VegaDeftwing/AnalogDrumMachine/README.md

# AnalogDrumMachine
Capstone Project @ UNL, 2020-2021
