VegaDeftwing/AnalogDrumMachine/ProductSpec2.md

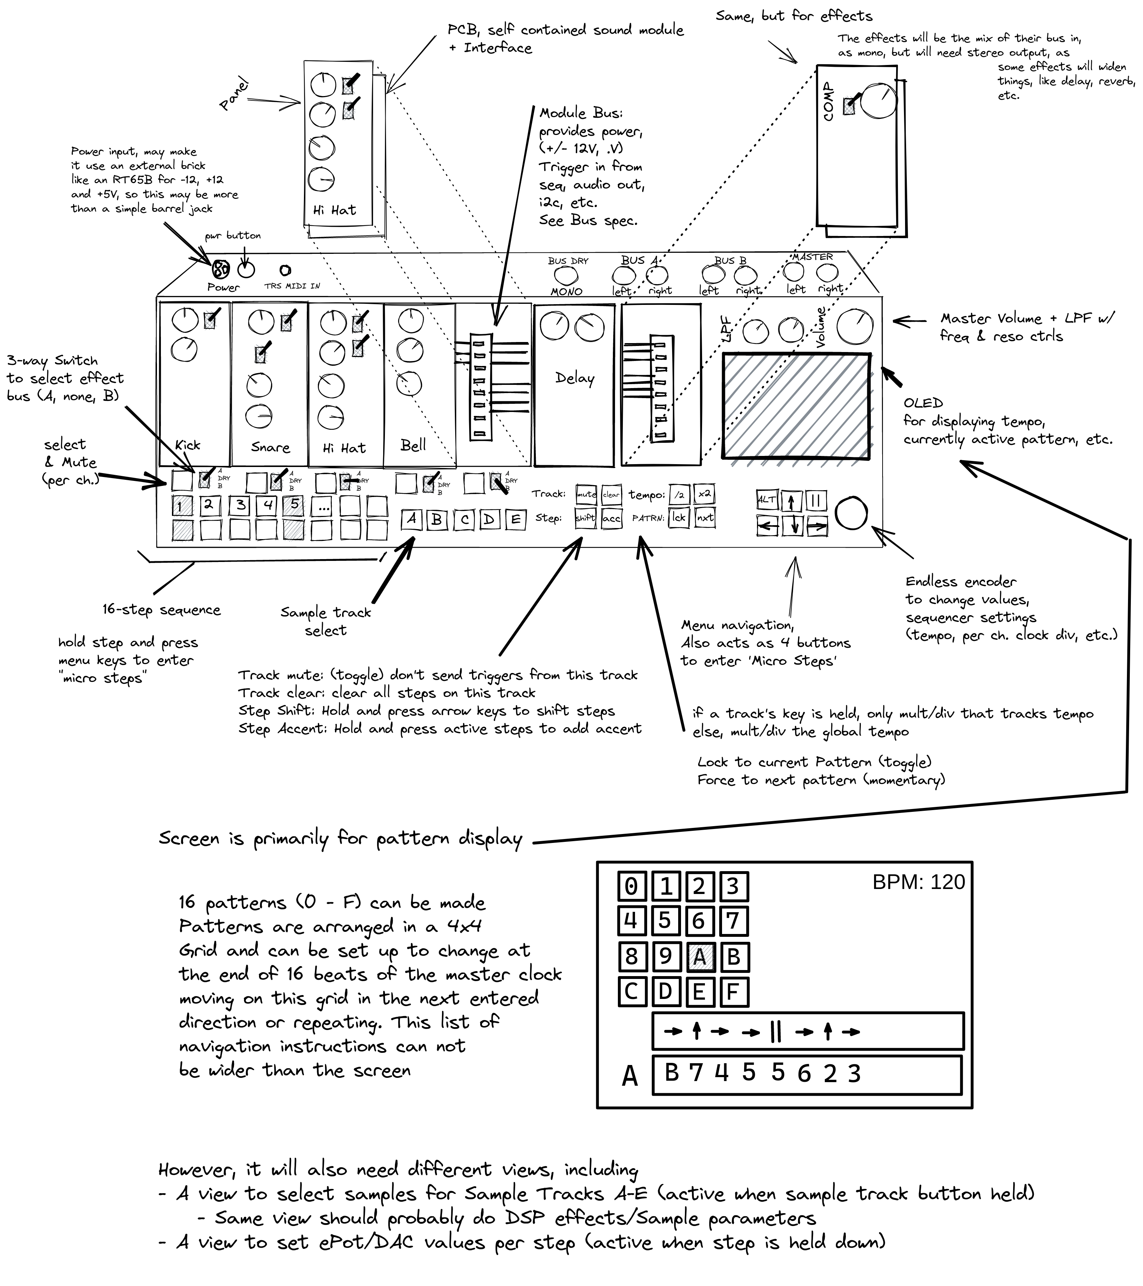
[picture p14: Images/DrumMachineConcept2.png]
DrumMachineConcept2
