VegaDeftwing/AnalogDrumMachine/Poster Board/Power_Enclosure.pdf

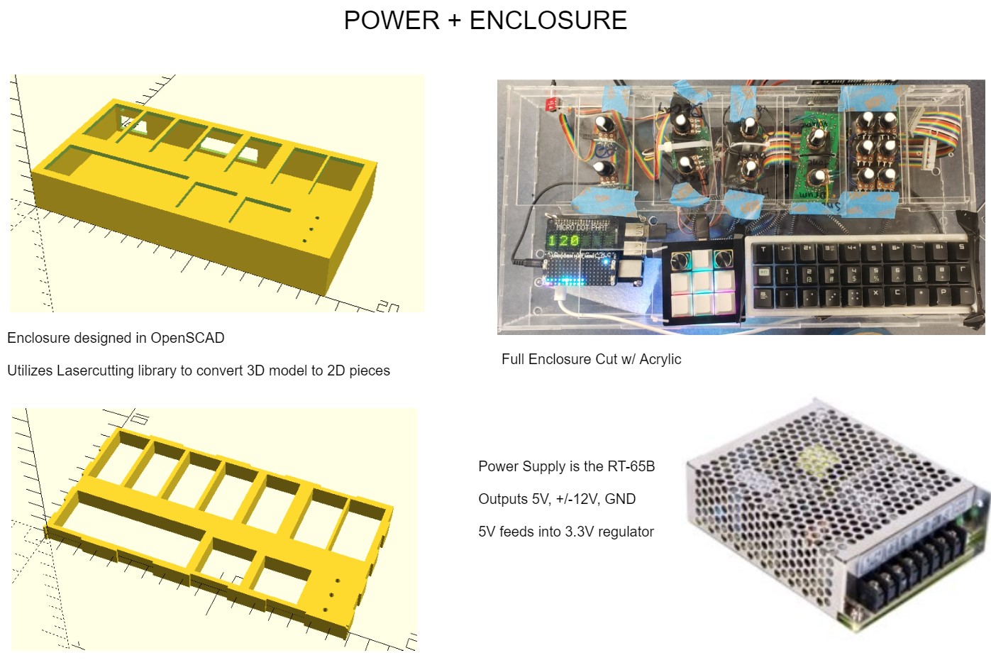
[picture p15: page 1]
