VegaDeftwing/AnalogDrumMachine/Poster Board/Snare.pdf

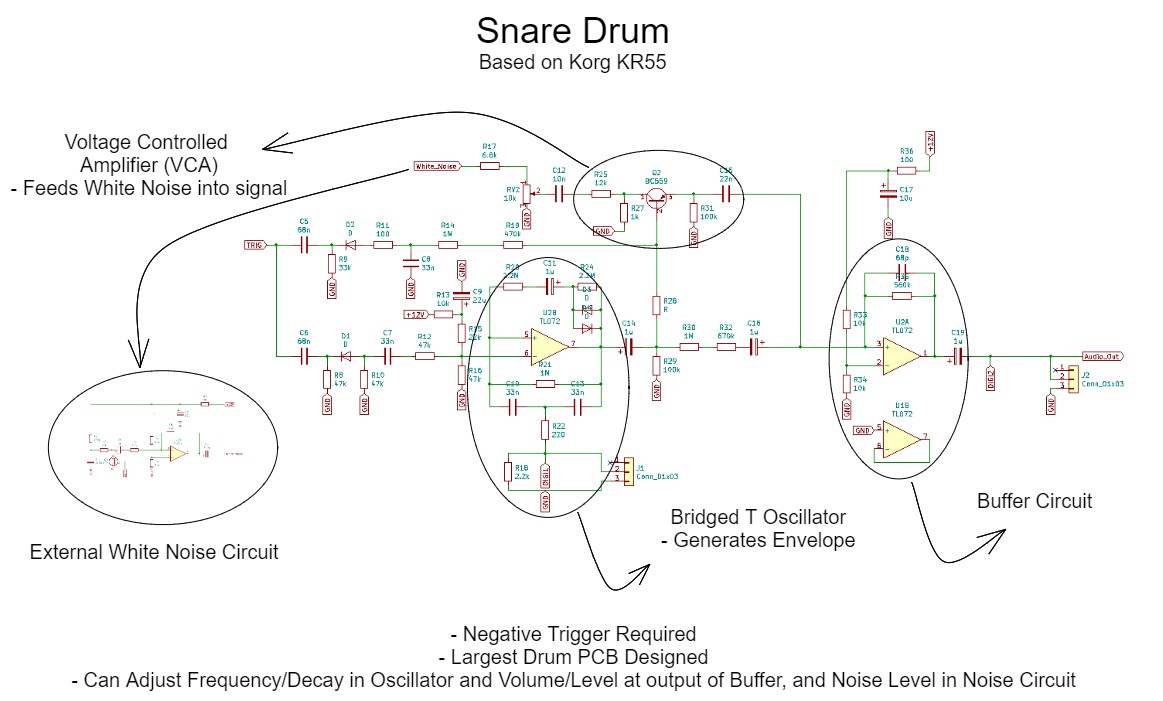
[picture p16: page 1]
