VegaDeftwing/AnalogDrumMachine/Poster Board/Title.pdf

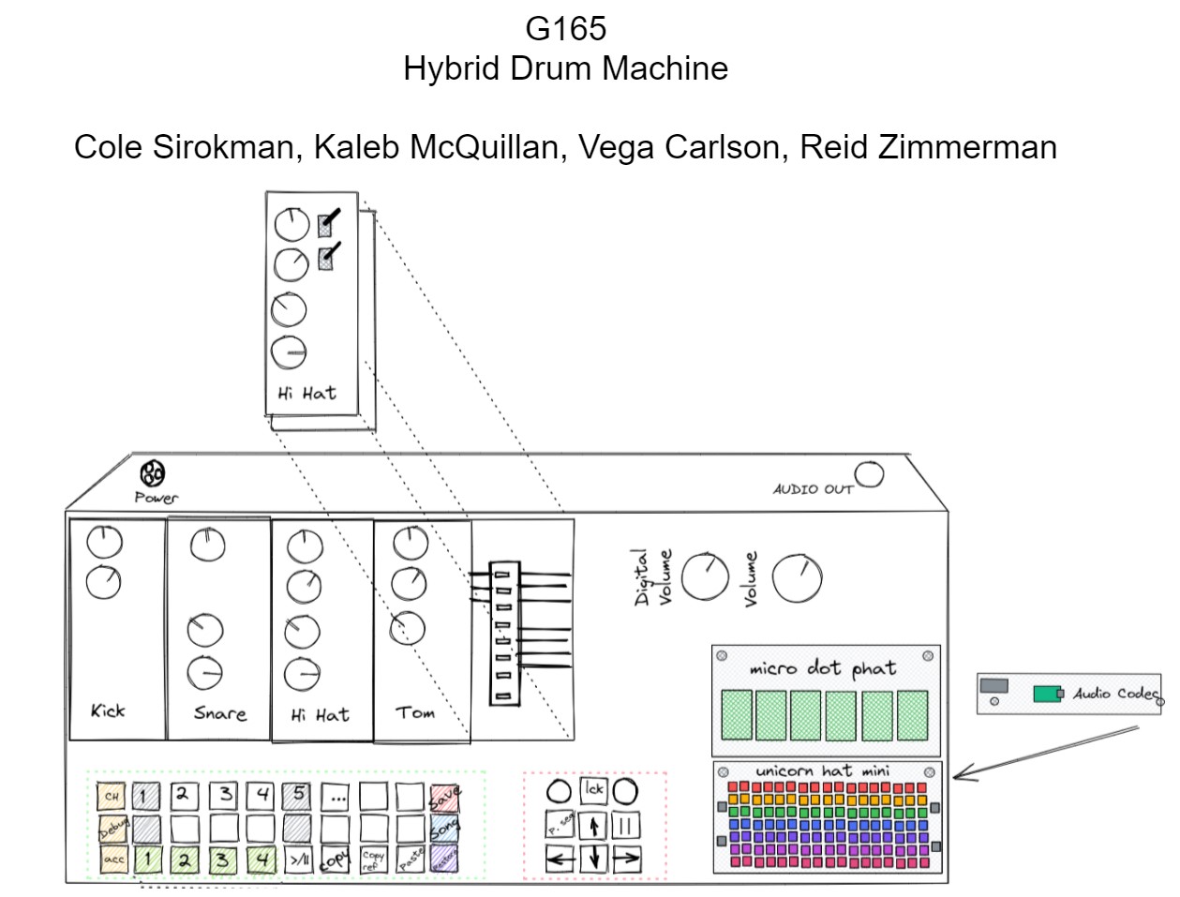
[picture p17: page 1]
