VegaDeftwing/AnalogDrumMachine/Images/displays.jpg

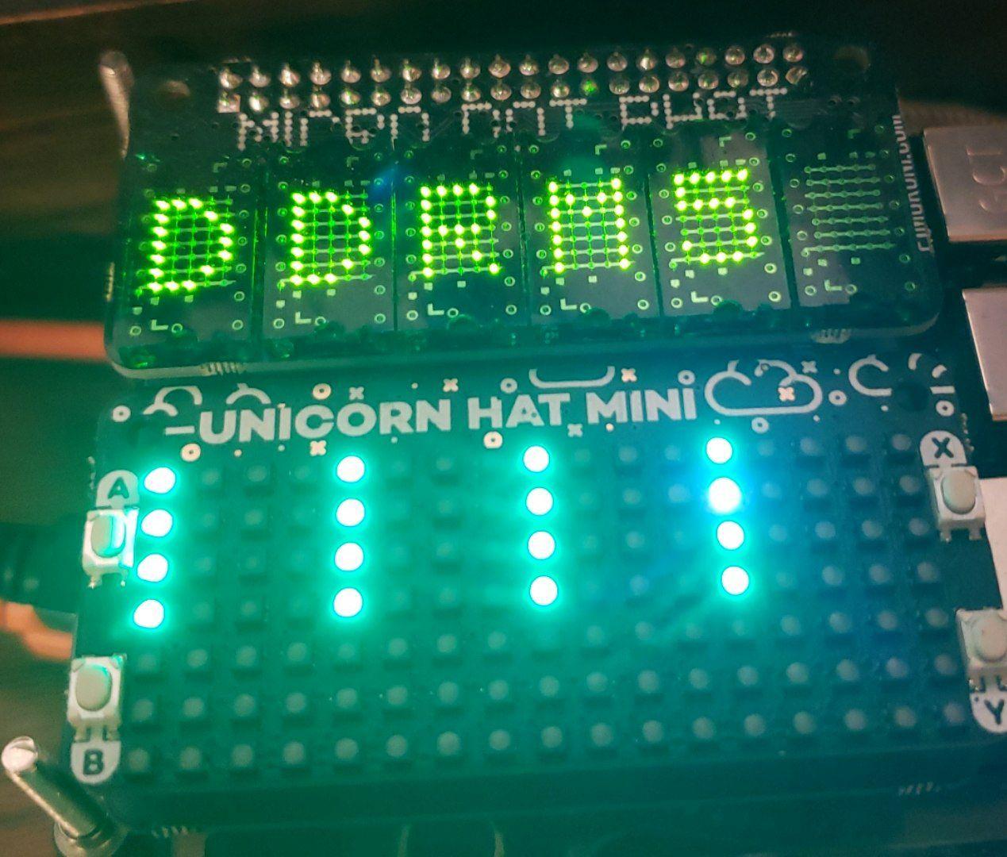
Images/displays.jpg
