VegaDeftwing/AnalogDrumMachine/Images/DrumMachineConcept5pretty.png

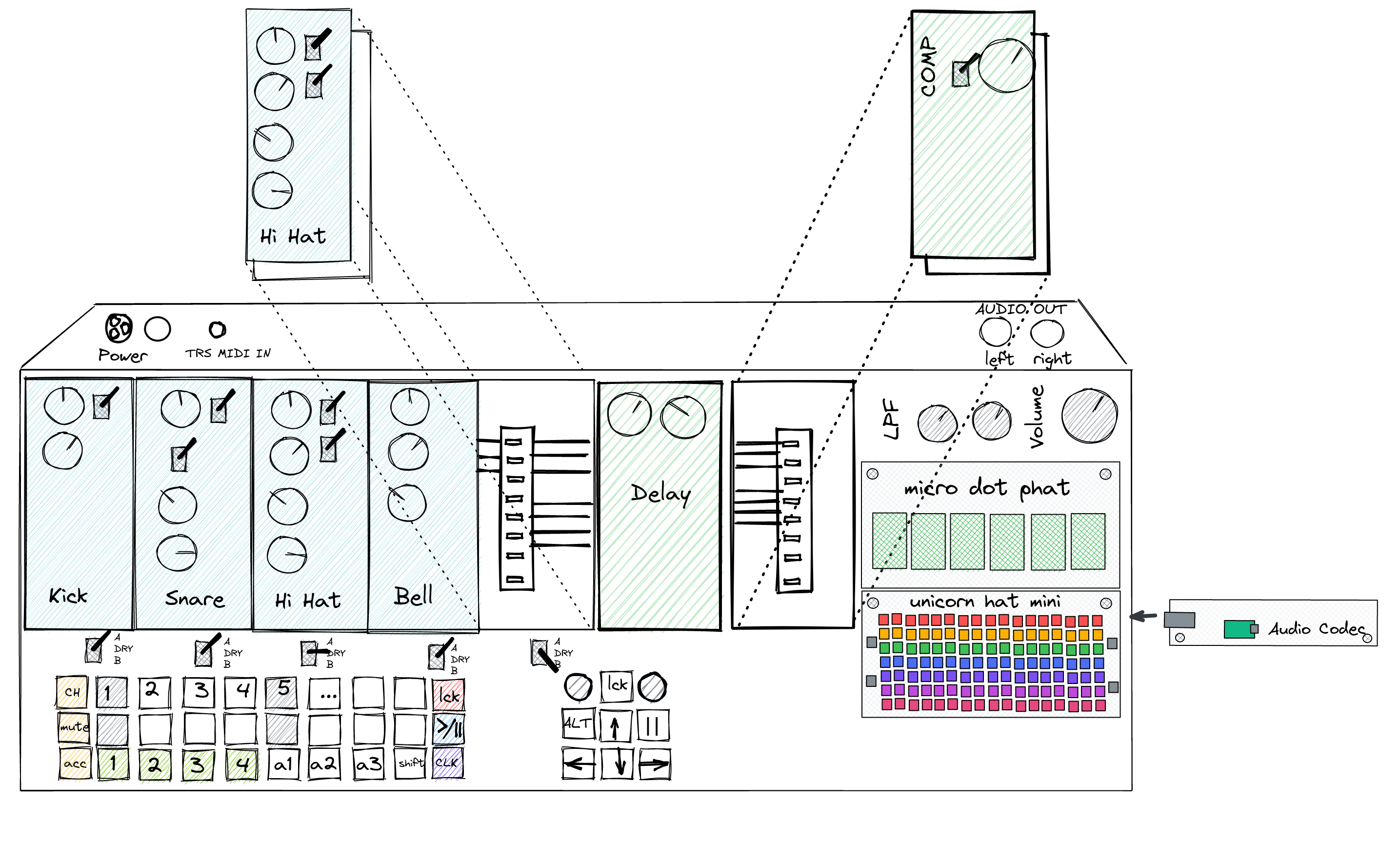
Images/DrumMachineConcept5pretty.png
