VegaDeftwing/AnalogDrumMachine/Images/Enclosure_Top.PNG

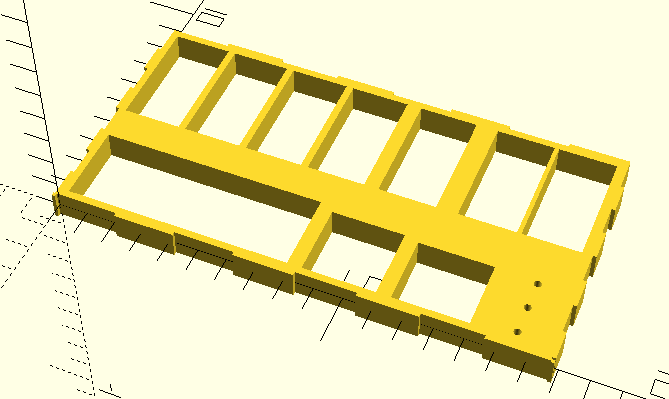
Images/Enclosure_Top.PNG
