VegaDeftwing/AnalogDrumMachine/Images/noise.PNG

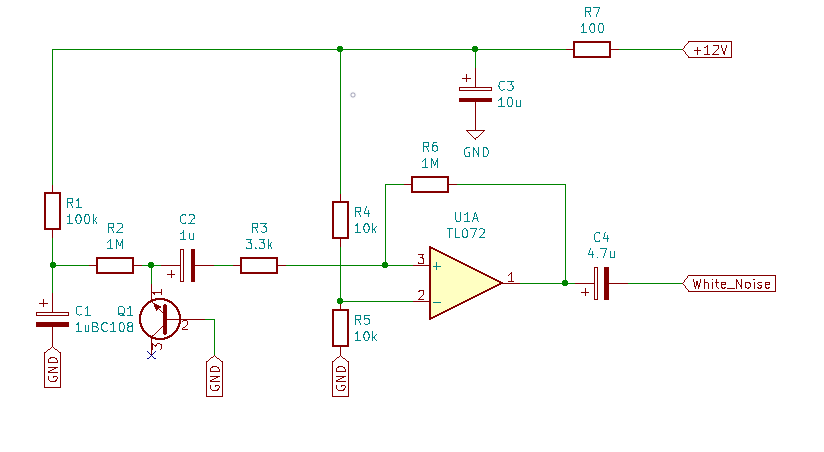
Images/noise.PNG
