VegaDeftwing/AnalogDrumMachine/Images/snare.PNG

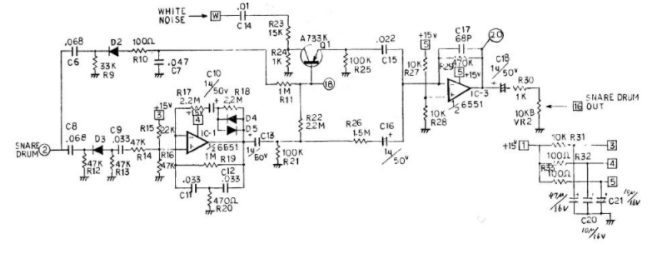
Images/snare.PNG
