VegaDeftwing/AnalogDrumMachine/Images/snare_kicad.PNG

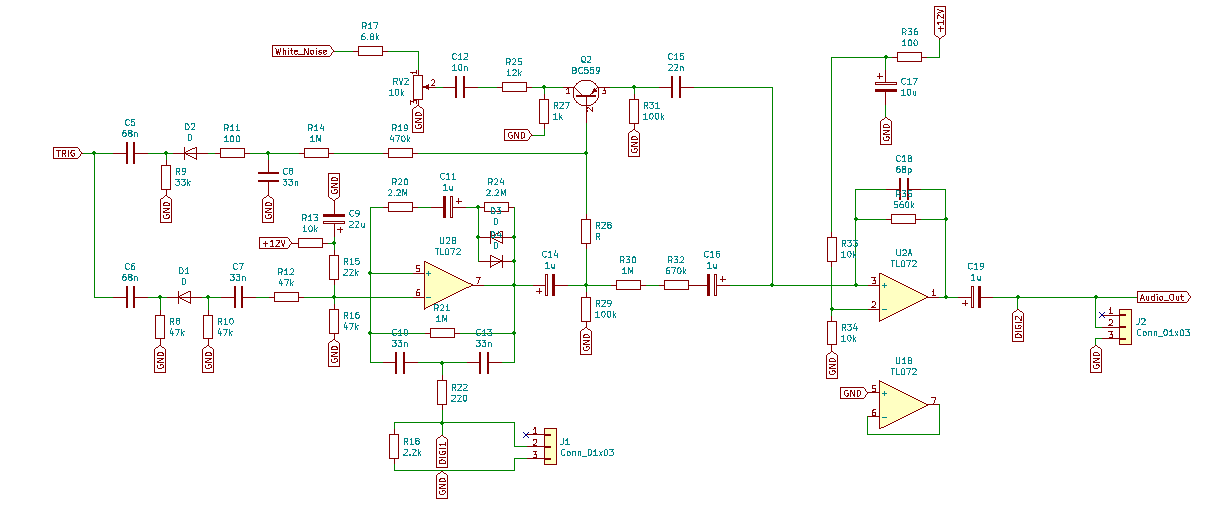
Images/snare_kicad.PNG
