VegaDeftwing/AnalogDrumMachine/Images/Supply.PNG

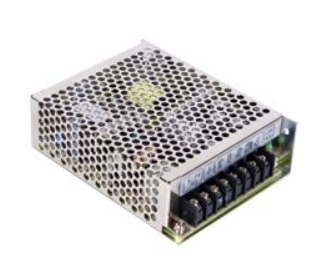
Images/Supply.PNG
