VegaDeftwing/AnalogDrumMachine/PCBs/Delay PCB/delaySchematic.png

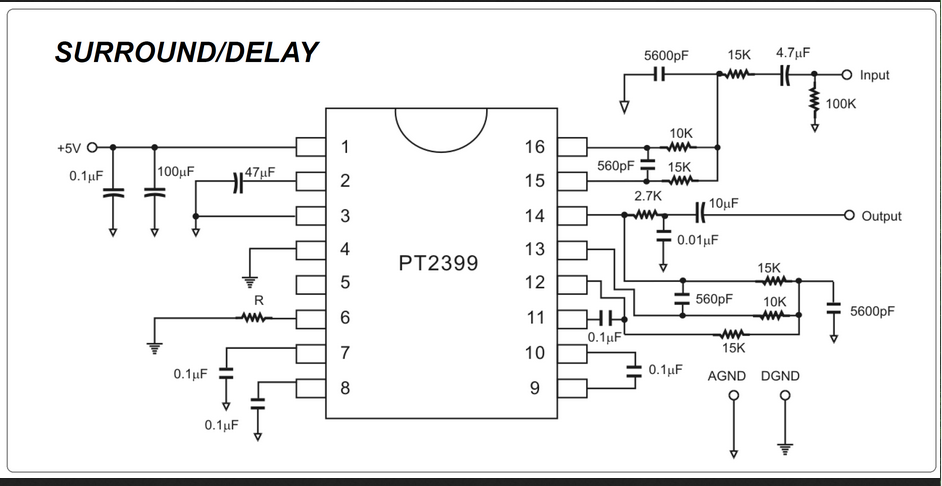
PCBs/Delay PCB/delaySchematic.png
