VegaDeftwing/AnalogDrumMachine/BOM/ControlBoardBOM.xlsx

Component | Value | Footprint | Description | Type | Description | Availability
C1 | 15pF | Capacitor_SMD:C_0805_2012Metric | Device | C | Unpolarized capacitor | Y
C2 | 15pF | Capacitor_SMD:C_0805_2012Metric | Device | C | Unpolarized capacitor | Y
C3 | 100nF | Capacitor_SMD:C_0805_2012Metric | Device | C | Unpolarized capacitor | Y
C4 | 10uF | Capacitor_SMD:C_0805_2012Metric | Device | C | Unpolarized capacitor | N
C5 | 100nF | Capacitor_SMD:C_0805_2012Metric | Device | C | Unpolarized capacitor | Y
C6 | 10uF | Capacitor_SMD:C_0805_2012Metric | Device | C | Unpolarized capacitor | N
C7 | 100nF | Capacitor_SMD:C_0805_2012Metric | Device | C | Unpolarized capacitor | Y
C8 | 100nF | Capacitor_SMD:C_0805_2012Metric | Device | C | Unpolarized capacitor | Y
C9 | 100nF | Capacitor_SMD:C_0805_2012Metric | Device | C | Unpolarized capacitor | Y
C10 | 100nF | Capacitor_SMD:C_0805_2012Metric | Device | C | Unpolarized capacitor | Y
C11 | 10uF | Capacitor_SMD:C_0805_2012Metric | Device | C | Unpolarized capacitor | N
D1 | D_Schottky | Diode_SMD:D_1206_3216Metric | Device | D_Schottky | Schottky diode | ?
D2 | LED | LED_SMD:LED_0805_2012Metric | Device | LED | Light emitting diode | ?
D3 | LED | LED_SMD:LED_0805_2012Metric | Device | LED | Light emitting diode | ?
D4 | LED | LED_SMD:LED_0805_2012Metric | Device | LED | Light emitting diode | ?
D5 | LED | LED_SMD:LED_0805_2012Metric | Device | LED | Light emitting diode | ?
J1 | USB_B_Micro | Connector_USB:USB_Micro-B_Molex_47346-0001 | rev1-rescue | USB_B_Micro-Connector |  | ?
J2 | Conn_01x03 | Connector_PinHeader_2.54mm:PinHeader_1x03_P2.54mm_Vertical | Connector_Generic | Conn_01x03 | Generic connector, single row, 01x03, script generated (kicad-library-utils/schlib/autogen/connector/) | Female or male?
J3 | Conn_01x08 | Connector_PinHeader_2.54mm:PinHeader_1x08_P2.54mm_Vertical | Connector_Generic | Conn_01x08 | Generic connector, single row, 01x08, script generated (kicad-library-utils/schlib/autogen/connector/) | Female or male?
J4 | Conn_01x05 | Connector_PinHeader_1.27mm:PinHeader_1x05_P1.27mm_Vertical | Connector_Generic | Conn_01x05 | Generic connector, single row, 01x05, script generated (kicad-library-utils/schlib/autogen/connector/) | Female or male?
J5 | Conn_01x04 | Connector_PinHeader_1.27mm:PinHeader_1x04_P1.27mm_Vertical | Connector_Generic | Conn_01x04 | Generic connector, single row, 01x04, script generated (kicad-library-utils/schlib/autogen/connector/) | Female or male?
J6 | Conn_01x01 | Connector_PinHeader_2.54mm:PinHeader_1x01_P2.54mm_Vertical | Connector_Generic | Conn_01x01 | Generic connector, single row, 01x01, script generated (kicad-library-utils/schlib/autogen/connector/) | Female or male?
R1 | 1K | Resistor_SMD:R_0805_2012Metric | Device | R | Resistor | Y
R2 | 27 | Resistor_SMD:R_0805_2012Metric | Device | R | Resistor | N | have 22 ohm 0805
R3 | 27 | Resistor_SMD:R_0805_2012Metric | Device | R | Resistor | N | have 22 ohm 0805
R4 | 5.6K | Resistor_SMD:R_0805_2012Metric | Device | R | Resistor | Y
R5 | 10K | Resistor_SMD:R_0805_2012Metric | Device | R | Resistor | Y
R6 | 10K | Resistor_SMD:R_0805_2012Metric | Device | R | Resistor | Y
R7 | 1K | Resistor_SMD:R_0805_2012Metric | Device | R | Resistor | Y
R8 | 1K | Resistor_SMD:R_0805_2012Metric | Device | R | Resistor | Y
R9 | 1K | Resistor_SMD:R_0805_2012Metric | Device | R | Resistor | Y
R10 | 1K | Resistor_SMD:R_0805_2012Metric | Device | R | Resistor | Y
R11 | 1K | Resistor_SMD:R_0805_2012Metric | Device | R | Resistor | Y
R12 | 100 | Resistor_SMD:R_0805_2012Metric | Device | R | Resistor | Y
R13 | 10K | Resistor_SMD:R_0805_2012Metric | Device | R | Resistor | Y
R14 | 4.7K | Resistor_SMD:R_0805_2012Metric | Device | R | Resistor | Y
R15 | 4.7K | Resistor_SMD:R_0805_2012Metric | Device | R | Resistor | Y
SW1 | SW_Push | Button_Switch_SMD:SW_SPST_CK_RS282G05A3 | Switch | SW_Push | Push button switch, generic, two pins | ?
U1 | RP2040 | RP2040:RP2040 | rev1-rescue | RP2040-rp2040 |  | ?
U2 | AZ1117-3.3 | Package_TO_SOT_SMD:SOT-223-3_TabPin2 | Regulator_Linear | AZ1117-3.3 | 1A 20V Fixed LDO Linear Regulator, 3.3V, SOT-89/SOT-223/TO-220/TO-252/TO-263 | ?
U3 | W25Q32JVSS | Package_SO:SOIC-8_5.23x5.23mm_P1.27mm | Memory_Flash | W25Q32JVSS | 32Mb Serial Flash Memory, Standard/Dual/Quad SPI, SOIC-8 | ?
Y1 | 12Mhz | Crystal:Crystal_SMD_SeikoEpson_FA238-4Pin_3.2x2.5mm | Device | Crystal_GND24 | Four pin crystal, GND on pins 2 and 4 | ?
