VegaDeftwing/AnalogDrumMachine/CAD/DXF/drumbox_flat_side2.dxf

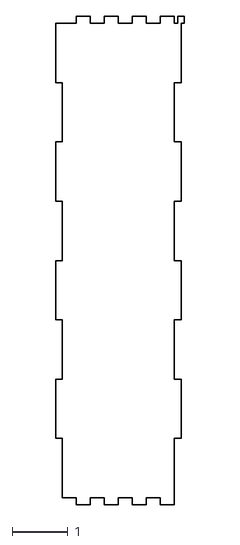
[picture p26: CAD file, 2022-05-05]
CAD/DXF/drumbox_flat_side2.dxf
2.31 x 8.75
