VegaDeftwing/AnalogDrumMachine/CAD/DXF/drumbox_flat.dxf

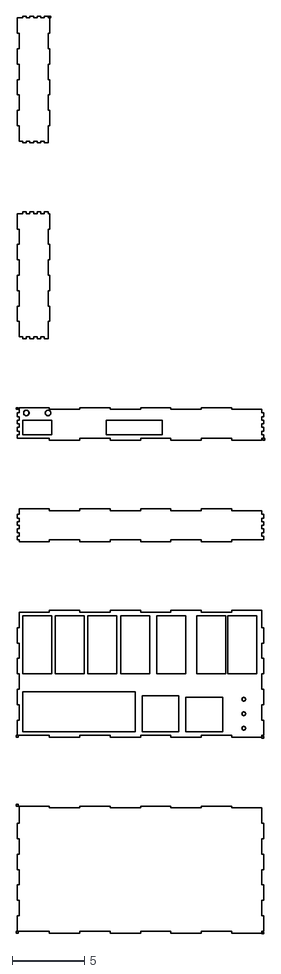
[picture p27: CAD file, 2022-05-05]
CAD/DXF/drumbox_flat.dxf
17.1 x 63.3
