VegaDeftwing/AnalogDrumMachine/CAD/DXF/drumbox_flat_back.dxf

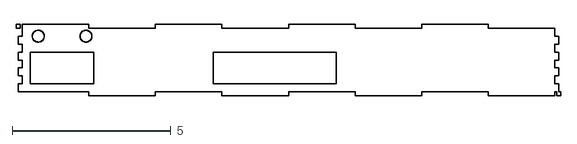
[picture p28: CAD file, 2022-05-05]
CAD/DXF/drumbox_flat_back.dxf
17.1 x 2.25
