VegaDeftwing/AnalogDrumMachine/CAD/DXF/drumbox_flat_top.dxf

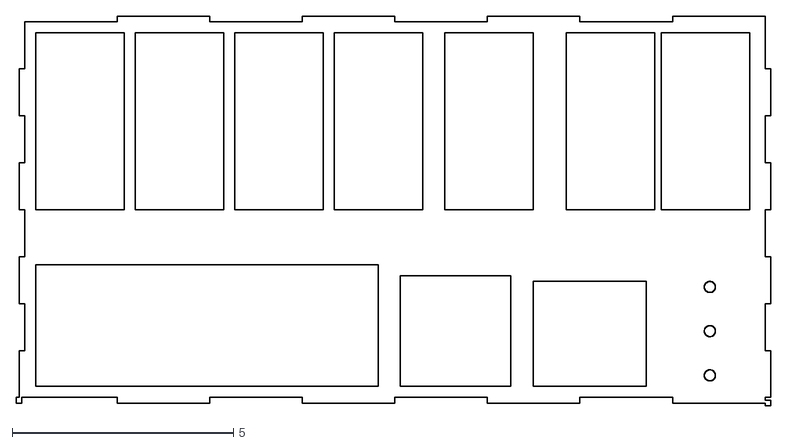
[picture p29: CAD file, 2022-05-05]
CAD/DXF/drumbox_flat_top.dxf
17.1 x 8.81
