VegaDeftwing/AnalogDrumMachine/CAD/DXF/drumbox_flat_side1.dxf

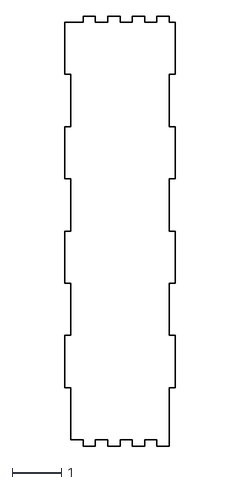
[picture p30: CAD file, 2022-05-05]
CAD/DXF/drumbox_flat_side1.dxf
2.25 x 8.75
