VegaDeftwing/AnalogDrumMachine/CAD/DXF/drumbox_flat_front.dxf

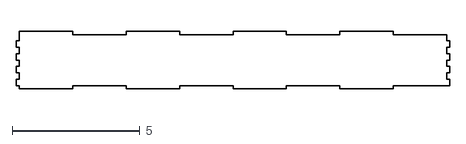
[picture p31: CAD file, 2022-05-05]
CAD/DXF/drumbox_flat_front.dxf
17.0 x 2.25
