VegaDeftwing/AnalogDrumMachine/CAD/DXF/drumbox_flat_bottom.dxf

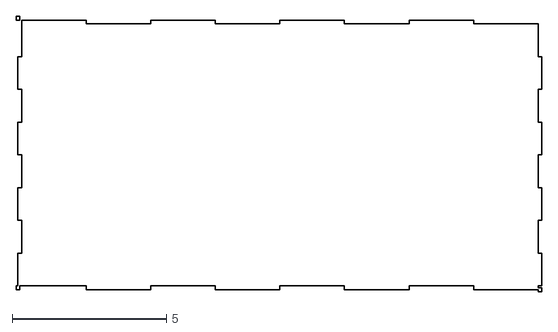
[picture p32: CAD file, 2022-05-05]
CAD/DXF/drumbox_flat_bottom.dxf
17.1 x 8.94
