VegaDeftwing/AnalogDrumMachine/(list of files, cad)

Other CAD files:
CAD/drumbox.scad
CAD/drumbox_flat_bottom.scad
CAD/drumbox_flat_front.scad
CAD/drumbox_flat_side2.scad
drumbox_flat_front.dxf
