VegaDeftwing/AnalogDrumMachine/Journal/VegaCarlsonJournalFall21w15.md

[TOC]

# Vega Carlson - Group 165 - Fall '21, Week 1

## Monday, Aug 2nd W:1.50 T:1.50 

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

## Tuesday, Aug 3rd -- W:5.00 T:5.00

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

exclidraw

This was also uploaded to github: [https://github.com/VegaDeftwing/AnalogDrumMachine](https://github.com/VegaDeftwing/AnalogDrumMachine)

## Wednesday, Aug 4th -- W:7.25 T:7.25

**1hr** Refinements of the concept sketch and feature list

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

harmonics

## Thursday, Aug 5th -- W:8.00 T.8.00

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

daughterboard

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

## Friday, Aug 6th -- W:9.50 T:9.50

**1.5hr** Group meeting, making timeline

---

**Week ending 8/27 total = 9.5hrs**

# Vega Carlson - Group 165 - Fall '21, Week 3

## Saturday, Sep 4th -- W:0.00 T:17.50

**0.00 hr** -- Sick, no progress today

## Sunday, Sep 5th -- W:0.00 T:17.50

**0.00hr** -- Sick, no progress today

## Monday, Sep 6th -- W:1.50 T:19.00

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

## Tuesday, Sep 7th -- W:1.50 T:19.00

**0.00hr** -- Sick, no progress today

## Wednesday, Sep 8th -- W:3.00 T:20.50

**0.5hr** -- Group meeting with Bauer, discussed state of the project, talked about the indistructable laptops

**0.5hr** -- Worked with LiveSpice to get circuit simulation with live audio output working

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

## Thursday, Sep 9th -- W:4.00 T:21.00

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

## Friday, Sep 10th -- W:6.00 T:23.00

**.75hr** Meeting with group

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

---

**Week ending 8/27 total = 6.0hrs**

# Vega Carlson - Group 165 - Fall '21, Week 4

## Saturday, Sep 11th -- W:0.00 T:23.00

**0.00 hr** -- No Progress today

## Sunday, Sep 12th -- W:0.70 T:23.70

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

## Monday, Sep 13th -- W:1.00 T:24.00

**0.3hr** -- Worked with ried building circuits in the lab

## Tuesday, Sep 14th -- W:2.30 T:25.30

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

## Wednesday, Sep 15th -- W:2.80 T:25.8

**0.5hr** - Meeting w/ Bauer

## Thursday, Sep 16th -- W:5.00 T:28.00

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

**1.0hr** - Bus selection, looking at i2c part options

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

## Friday, Sep 17th -- W:8.00 T:31.00

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

**1.2hr** - Group meeting, see minutes

**1.1hr** - Redesign of concept sketch

DrumMachineConcept2

---

**Week ending 9/17 total = **8.0 hours

# Vega Carlson - Group 165 - Fall '21, Week 5

## Saturday, Sep 18th -- W:0.00 T:31.00

**0.00 hr** -- No Progress today

## Sunday, Sep 19th -- W:4.00 T:35.00

**4.00hrs** -- Drastically updated the product spec + discussion with group about some terminology

DrumMachineConcept3

## Monday, Sep 20th -- W:6.00 T:37.0

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

## Tuesday, Sep 21st -- W:6.00 T:37.0

**0.0hr** -- No work on the project today

## Wednesday, Sep 22nd -- W:6.7 T:37.7

**0.5hr** - Meeting w/ Bauer

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

## Thursday, Sep 23rd -- W:6.7 T:37.7

**0.0hr** - No work on the project today

## Friday, Sep 24th -- W:8.00 T:39.0

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

---

**Week ending 9/24 total = **8.0 hours

# Vega Carlson - Group 165 - Fall '21, Week 6

## Saturday, Sep 25th -- W:0.00 T:39.00

**0.00 hr** -- No Progress today

## Sunday, Sep 26th -- W:0.00 T:39.00

**0.00hrs** -- No Progress today

## Monday, Sep 27th -- W:0.50 T:39.5

**0.5hr** -- Worked with Ried in the lab briefly to progress on the sna 

## Tuesday, Sep 28th -- W:5.50 T:44.5

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

## Wednesday, Sep 29th -- W:6.2 T:45.2

**0.0hr** - Meeting w/ Bauer, was significantly late

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

## Thursday, Sep 30th -- W:7.2 T:46.2

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

## Friday, Oct 1st -- W:8.00 T:47.0

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

---

**Week ending 10/1 total = **8.0 hours

# Vega Carlson - Group 165 - Fall '21, Week 7

## Saturday, Oct 2nd -- W:0.00 T:47.00

**0.0 hr** -- No Progress today

## Sunday, Oct 3rd -- W:0.00 T:47.00

**0.0hrs** -- No Progress today

## Monday, Oct 4th -- W:0.60 T:47.6

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

## Tuesday, Oct 5th -- W:0.60 T:47.6

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

## Wednesday, Oct 6th -- W:2.60 T:49.6

**0.5hr** -- Meeting with Bauer

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

## Thursday, Oct 7th -- W:6.1 T:53.1

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

DrumMachineConcept4

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

---

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

## Friday, Oct 8th-- W:8.00 T:55.0

**0.5hr** -- Group meeting in lab

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

---

**Week ending 10/8 total = **8.0 hours

# Vega Carlson - Group 165 - Fall '21, Week 8

## Saturday, Oct 9th -- W:0.00 T:55.00

**0.0 hr** -- No Progress today

## Sunday, Oct 10th -- W:0.00 T:55.00

**0.0hrs** -- No Progress today

## Monday, Oct 11th -- W:1.0 T:56.00

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



## Tuesday, Oct 12th -- W:1.7 T:57.7

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

## Wednesday, Oct 13th -- W:4.5 T:60.5

**0.5hr** -- Meeting with Bauer

**0.6hr** -- Worked in lab with others

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

## Thursday, Oct 14th -- W:5.5 T:61.5

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

## Friday, Oct 15th-- W:8.1 T:64.1

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



(image from https://www.masterzen.fr/2018/12/16/handwired-keyboard-build-log-part-1/)

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

**1.0hr** -- Meeting + worked in lab on FM drum with Ried

---

**Week ending 10/15 total = **8.1 hours

# Vega Carlson - Group 165 - Fall '21, Week 9

## Saturday, Oct 16th -- W:0.00 T:64.1

**0.0 hr** -- No Progress today

## Sunday, Oct 17th -- W:0.00 T:64.1

**0.0hrs** -- No Progress today

## Monday, Oct 18th -- W:0.0 T:64.1

**0.0hrs** -- No Progres Today

## Tuesday, Oct 19th -- W:4.0 T:68.1

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

## Wednesday, Oct 20th -- W:4.9 T:69.0

**0.5hr** -- Meeting with Bauer

**0.4hr** -- Explained code so far to the rest of the group 

## Thursday, Oct 21st -- W:5.2 T:69.3

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

## Friday, Oct 22nd-- W:5.2 T:69.3

**0.0hr** -- No progress today, and missed meeting (planned)

---

**Week ending 10/22 total = **5.2 hours.

**NOTE: two day break this week, so goal was only 4.8 hours**

# Vega Carlson - Group 165 - Fall '21, Week 10

## Saturday, Oct 23rd -- W:0.00 T:69.3

**0.0 hr** -- No Progress today

## Sunday, Oct 24th -- W:2.70 T:72.0

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

## Monday, Oct 25th -- W:5.0 T:74.3

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

## Tuesday, Oct 26th -- W:5.0 T:74.3

**0.0hr** -- no progress today

## Wednesday, Oct 27th -- W:6.0 T:75.3

**1hr** -- Meeting in lab with everyone

## Thursday, Oct 28th -- W:7.5 T:76.8

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

## Friday, Oct 29th-- W:8.5 T:77.8



**1.0hr** -- Meeting with group, see minutes + general discussion & work in lab

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

---

**Week ending 10/28 total = **8.5 hours

# Vega Carlson - Group 165 - Fall '21, Week 11

## Saturday, Oct 30th -- W:0.00 T:77.8

**0.0 hr** -- No Progress today

## Sunday, Oct 31st -- W:0.00 T:77.8

**0.0hrs** -- No Progress today

## Monday, Nov 1st -- W:1.2 T:79.0

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



## Tuesday, Nov 2nd -- W:3.9 T:81.7

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



## Wednesday, Nov 3rd -- W:4.9 T:82.7

**1hr** -- Meeting with Bauer + work in lab 

## Thursday, Nov 4th -- W:7.0 T:84.8

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

## Friday, Nov 5th -- W:9.0 T:86.8

**2.0hr** -- Meeting + work in lab with Kaleb doing soldering. It didn't go overly well.

---

**Week ending 11/5 total = **9.0 hours

# Vega Carlson - Group 165 - Fall '21, Week 12

## Saturday, Nov 6th -- W:0.00 T:86.8

**0.0 hr** -- No Progress today

## Sunday, Nov 7th -- W:0.00 T:86.8

**0.0hrs** -- No Progress today

## Monday, Nov 8th -- W:0.00 T:86.8

**0.0hrs** -- No Progress today

## Tuesday, Nov 9th -- W:0.00 T:86.8

**0.0hrs** -- No Progress today

## Wednesday, Nov 10th -- W:0.5 T:87.3

**0.5hr** -- Meeting with Bauer

## Thursday, Nov 11th -- W:7.6 T:93.9

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

---

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

---

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

---

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

https://github.com/boppreh/keyboard/issues/158

> Noting for myself, to flash the BDN9 use:
>
> `qmk flash -kb keebio/bdn9/rev2 -km capstone`

## Friday, Nov 12th -- W:9.8 T:96.1

**0.5hr** -- Meeting

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

---

**Week ending 11/12 total = **9.8 hours

# Vega Carlson - Group 165 - Fall '21, Week 13

## Saturday, Nov 13th -- W:0.00 T:96.1

**0.0 hr** -- No Progress today

## Sunday, Nov 14th -- W:0.50 T:96.6

**0.5hrs** -- High level research into effect options and parts needed moving forward. Ordered PT2399's

## Monday, Nov 15th -- W:1.00 T:97.1

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

## Tuesday, Nov 16th -- W:0.00 T:97.1

**0.0hrs** -- No Progress today

## Wednesday, Nov 17th -- W:1.7 T:97.8

**0.7hr** -- Meeting with Bauer + some work in lab

## Thursday, Nov 18th -- W:7.4 T:103.5

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

## Friday, Nov 19th -- W:8.2 T:104.3

**0.5hr** + **.3hr** -- Meeting + contintued discssion about filters with Kaleb

---

**Week ending 11/12 total = **8.2

# Vega Carlson - Group 165 - Fall '21, Week 14 (Thanksgiving Break: 20-27th)

Ordered the RP2040's from Adafruit, PT2399's arrived

# Vega Carlson - Group 165 - Fall '21, Week 15

## Saturday, Nov 28th -- W:0.0 T:103.5

**0.0hrs** -- No Progress today

## Sunday, Nov 29th -- W:0.0 T:103.5

**0.0hrs** -- No Progress today

## Monday, Nov 30th -- W:0.0 T:103.5

**0.0hrs** -- No Progress today

## Tues, Nov 31st -- W:0.0 T:103.5

**0.0hrs** -- No Progress today

## Wednesday, Dec 1st -- W:0.5 T:104.0

**0.5hrs** -- Meeting with Bauer, see minutes, RP2040's

## Thursday, Dec 2nd -- W:0.5 T:104.0

**0.0hrs** -- No Progress today

## Friday, Dec 3rd -- W:1.0 T:104.5

**0.5hrs** -- Meeting with group, see minutes

**Week ending 11/12 total = **1.0

# Vega Carlson - Group 165 - Fall '21, Week 15

## Saturday, Dec 4th -- W:0.0 T:104.5

**0.0hrs** -- No Progress today

## Sunday, Dec 5th -- W:0.0 T:104.5

**0.0hrs** -- No Progress today

## Monday, Dec 6th -- W:0.0 T:104.5

**0.0hrs** -- No Progress today

## Tues, Dec 7th -- W:2.7 T:107.2

**2.7hrs** -- Updated the pi, which also meant a kernel and bootloader update. This wasn't strictly necessary, but I'm used to arch where everything is rolling release and I think it's good practice so ╮(─▽─)╭. This took some time as I needed to check all the I/O / hats to make sure everything was still working, it is.

After that I started looking at code and trying to figure out how to best do the midi out to PD. I did actually manage to get some sound out, but something is weird and the sequence of notes being played isn't match that on the display. Unfortuantly, at least for now I don't have the slightest idea why. Before I go much further though, I need to get at least one sample drum working in PD on the pi, as I think the bug may have actually been caused by note off events (ironically) triggering the note on, but sometimes preventing the triggering of the next note. I have a patch mostly setup (see Nov 18th) but it's not working on the pi, even after doing what I thought were all the neccasry changes to make it run headless. I'm going to need to debug more. But, hey, at least the main program is somewhat working, even if at the moment the triggers its sending make no sense, we're getting sound out from a sequencer!

Thinking for the future, I'd like to at least figure out how we're getting trigs and values to the pico (MIDI, direct serial?), and parameter saving per step not being the mess it is.

## Wednesday, Dec 8th-- W:4.5 T:109.0

**0.5hrs** -- Meeting with Bauer, see minutes

**0.5hr** -- Work in lab with others, setting up $\LaTeX$ doc and Google Slides. My laptop decided I didn't need to be able to work on campus, so despite being in the lab much longer, I'm only counting this as half an hour

**0.8hr** -- Work on Google Slides

### Hour bump from past work

Counting time from Ethics assignment & Two outside lectures. That's roughly +5 hours. --> going to 114.0hrs

## Thursday, Dec 9th -- W:9.2 T:118.7

**4.7hrs** -- Continued work on sildes, Continued work on $\LaTeX$ doc, recorded presentation, wrote up final thoughts

## Friday, Dec 10th -- W:10.0 T:119.5

**0.3hrs** -- Fixed $\LaTeX$ report formatting issues

**0.5hrs** -- Meeting with group, see minutes

**Week ending 11/12 total = **119.5

---

# END OF ECEN494 -- 119.5 Hours
