VegaDeftwing/AnalogDrumMachine/Journal/G165Minutes211013.md

# G165 Minutes 21.10.13

  **Attending:** Vega Carlson, Kaleb McQuillan, Reid Zimmerman, Cole Sirokman, Mark Bauer

---

  **What you've done:**

  Vega: Ordered pi hats, sorted parts

  Kaleb: Worked more with snare circuit, trying new ideas

  Reid: Made significant progress on the 2x Atari Punk Console (4x 555) circuit

  Cole: Continued work on toms, trying to work with analog mux to select caps

---

## Minutes

11:00 - Start of meeting

11:07 - started with talk of 3D printed cube, long dead projects namely DNA projects

11:08 - pi 3/4? use 3b+ since on hand

11:09 - Card Edge? use 2.54mm pins

11:16 - Digipots? oshpark some interposers for the SOP10 parts

11:19 - How are drums going: HiHat & Snare are complicated, trying various ideas

11:23 - Clarification on micro: need to put the rp2040 on board directly, not make a socket. The keyboards keep the solder on boards, as they're pre-made

11:30 - end of meeting

## Action Items

Vega:

- [ ] Organizing Pseudocode for Project - By October 15th, 2021

Kaleb:

- [ ] Work more with snare circuit, maybe get to BBD Delay Module By October 15th, 2021

Reid:

- [ ] Work more on Atari Punk Console - By October 15th, 2021
- [ ] Put any semi-finalized schematics in KiCAD - By October 15th, 2021

Cole:

- [ ] Work on tuning bass drum to get tom sound, possibly start fake sidechain drone - By October 15th, 2021

## Timeline

### Wk 1 - Aug 27

  - [x] Basic project idea & outline
  - [x] Get group on the same page about how a drum machine works

### Wk 2 - Sep 3

  - [x] Project approval
  - [x] Get analog circuit simulation working
  - [x] Get at least one module simulated

### Wk 3 - Sep 10

  - [x] Picking specific modules
    - [x] Sounds
    - [x] Effects
  - [ ] Simulations of some drums

### Wk 4 - Sep 17

  - [ ] ~~Order basic parts that we're certain on~~
  
    > Vega has most of these parts on hand
  
  - [x] Simulation of half of the drum modules

### Wk 5 - Sep 24

  - [ ] ~~Simulation of other half of drum modules~~
  - [x] Half of drum modules breadboarded
  - [x] Basic mock up of UI
    - [x] Sequencer
    - [x] Midi clocking

### Wk 6 - Oct 1

- [x] Work on drum breadboard circuits

### Wk 7 - Oct 8

- [x] Work on drum breadboard circuits cont.

### Wk 8 - Oct 15

- [x] Order stuff to work with pi

- [ ] Finalize Bus pinout

- [ ] Start code organization/very high level pseudo code

### Wk 9 - Oct 22

- [ ] Start Bassdrum/Toms PCB
- [ ] Get Digipot Interposer ordered
- [ ] Document Drum designs at current state
- [ ] Determine what pins on the pico will be used for what purpose
- [ ] Start sequencer/display Pi code

### Wk 10 - Oct 29

- [ ] At least one revision of the first drum PCB
- [ ] Sequencer/display Pi code cont.
  - [ ] Use a MIDI controller as input until keyboards are ordered?

### Wk 11 - Nov 5

- [ ] Get all 3 pi hats working (Assuming they're here)
- [ ] Keyboard PCBs Ordered (Alpha & BDN9)
- [ ] **DUE: Two Breadboard'd drums connected to breadboard bus, getting triggers from micro**

### Wk 12 - Nov 12

- [ ] Bass & Tom drum PCB design

### Wk 13 - Nov 19

- [ ] **DUE: Drum PCB for Bass Drum / Tom ordered**

### Wk 14 - Nov 26

- [ ] FM Drum & Drone PCB designed

### Wk 15 - Dec 3

- [ ] **DUE: Ability to recieve inputs from micro & display events on screen**
- [ ] FM Drum & Drone PCB oredered
- [ ] Snare & Hat PCB(s) Designed

### Wk 16 - Dec 10

- [ ] Snare & Hat PCBs Ordered

**end of semester**

----

~~ Vaugly sometime next semester: ~~

- [ ] Karplus Strong Drum
- [ ] Enclosure Design
- [ ] Effect Modules (Need to re-think selection)
  - [ ] Distortion
  - [ ] Bit/Sample rate reduction
  - [ ] Delay
  - [ ] Compression
  - [ ] Guitar Pedal Interface
- [ ] RP2040 'Brain' board design
- [ ] PSU selection
- [ ] Master Volume & Filter board
