VegaDeftwing/AnalogDrumMachine/Journal/G165 Minutes 21.10.01.md

# G165 Minutes 21.10.01

**Attending:** Vega Carlson, Kaleb McQuillan, Reid Zimmerman, Cole Sirokman

---

**What you've done:**

Vega:

- [x] Get some data from the Pico to the Pi - by Friday, October 1st 2021

Kaleb:

- [x] Breadboard a couple of VCA iterations, potentially connect them to the envelope generator and test. - by Friday, October 1st 2021

Reid:

- [x] Refine the snare circuit to make it sound better - by Friday, October 1st 2021

Cole:

- [x] Clean up the base drum circuit to reduce noise distortion. - by Friday, October 1st 2021

---

## Minutes

2:45 Kaleb is working on improving the functionality of the VCA of the snare drum circuit. 

2:50 Reid will be researching the Atari Punk Console to implement our FM drums.

2:55 Initial testing of snare drum circuit with VCA is unsuccesful.

3:00 Vega is in the process of choosing a screen. A nicer HyperPixel screen may require using a USB audio interface that could incur additional work.

3:05 Tuning bass drum circuit to get a higher frequency tom sound. The output is distorted at high frequencies.

3:15 More testing of VCA circuit is again unsuccessful, providing a noisy output.

3:25 Everyone has a goal set for next week.

## Action Items

Vega:

- [ ] Find parts for UI (buttons and screen) - October 8th, 2021

Kaleb:

- [ ] Start on BBD delay module - By October 8th, 2021

Reid:

- [ ] Start bass drum PCB schematics in KiCAD - By October 8th, 2021
- [ ] Research the Atari Punk Console - By October 8th, 2021

Cole:

- [ ] Work on tuning bass drum to get tom sound, possibly start fake sidechain drone - By October 8th, 2021

## Timeline

## Wk 1 - Aug 27

- [x] Basic project idea & outline
- [x] Get group on the same page about how a drum machine works

## Wk 2 - Sep 3

- [x] Project approval
- [x] Get analog circuit simulation working
- [x] Get at least one module simulated

## Wk 3 - Sep 10

- [x] Picking specific modules
  - [x] Sounds
  - [x] Effects
- [ ] Simulations of some drums

## Wk 4 - Sep 17

- [ ] ~~Order basic parts that we're certain on~~

  > Vega has most of these parts on hand

- [x] Simulation of half of the drum modules

## Wk 5 - Sep 24

- [ ] ~~Simulation of other half of drum modules~~
- [x] Half of drum modules breadboarded
- [x] Basic mock up of UI
  - [x] Sequencer
  - [x] Midi clocking

## Wk 6 - Oct 1

## Wk 7 - Oct 8

- [ ] Protoboard all drum modules

## Wk 8 - Oct 15

- [ ] Protoboard all effect module

## Wk 9 - Oct 22

- [ ] Protoboard sequencer
- [ ] Make PCBs for module edge connectors

## Wk 10 - Oct 29

- [ ] Basic sequencer functionality
- [ ] Simulation of effect modules
- [ ] Finalize bus connections (power, data, trigger, etc.)
  - [ ] sources
  - [ ] effects

## Wk 11 - Nov 5

- [ ] Effect bus functionality
  - [ ] Mixing
- [ ] Sequencer functionality continued

## Wk 12 - Nov 12

- [ ] PCB design of drum modules

## Wk 13 - Nov 19

- [ ] PCB design of effect modules

## Wk 14 - Nov 26

- [ ] PCB design of Sequencer
- [ ] PCB design of Mainboard
- [ ] Order PCBs

## Wk 15 - Dec 3

- [ ] Sequencer software Continued

## Wk 16 - Dec 10

- [ ] Sequencer software continued 

**end of semester**

----
