VegaDeftwing/AnalogDrumMachine/Journal/G165Minutes210910.md

# G165 Minutes 21.09.10

**Attending:** Vega Carlson (Virtually), Kaleb McQuillan, Reid Zimmerman, Cole Sirokman

---

**What you've done:**

Vega:

- [ ] Figure out bus structure and choose μC for sequncer - by Friday, September 10th 2021  

  NOTE: Vega was sick most of the week, task moved to next week.

  He did think about the processor that would be used, and he suggested using a Raspberry Pi because it helps us have a lot of different processes happening in real time. 

Kaleb:

- [ ] Simulate an Attack/Decay envelope gen - by Friday, September 10th 2021

  Found some circuits that seem like they will work. Simulations have been difficult because he is doing them in LTSpice, where libraries can be a little difficult. He says he is confident in his circuit though. 

Reid:

- [x] Simulate Snare Drum using LiveSpice by Friday, September 10th 2021

  Snare Drum simulations were difficult because simulation software tends to remove white noise, so the waveforms were not perfect. 

Cole:

- [ ] Simulate Toms using LiveSpice - by Friday, September 10th 2021

  Simulated in LiveSpice. Set up was a little funky, so he is going to try to work with it more this week. 

---

## Minutes

3:20 Start of meeting

3:25 Discuss action items from previous week and create action items for next week

3:35 Update timeline and move around tasks

3:40 Discussed Raspberry Pi and how it would be integrated into our project

3:45 Discussed substitution of components in previously simulated circuits 

4:00 End of meeting

## Action Items

Vega:

- [ ] Figure out bus structure and choose μC for sequncer (CONTINUED) - by Friday, September 17th 2021  

Kaleb:

- [ ] Simulate an Attack/Decay envelope gen (CONTINUED) - by Friday, September 17th 2021

Reid:

- [ ] Build Snare Drum on breadboard and do more simulations by Friday, September 17 2021

Cole:

- [ ] Continue work for Toms and try breadboarding the toms circuit by Friday, Sempteber 17 2021

## Timeline

## Wk 1 - Aug 27

- [x] Basic project idea & outline
- [x] Get group on the same page about how a drum machine works

## Wk 2 - Sep 3

- [x] Project approval
- [x] Get analog circuit simulation working
- [x] Get at least one module simulated

## Wk 3 - Sep 10

- [x] Picking specific modules
  - [x] Sounds
  - [x] Effects
- [x] Simulations of some drums

## Wk 4 - Sep 17

~~Order basic parts that we're certain on~~

- [ ] Basic mock up of UI
  - [ ] Sequencer
  - [ ] Midi clocking
- [ ] Simulation of half of the drum modules

## Wk 5 - Sep 24

- [ ] Simulation of other half of drum modules

## Wk 6 - Oct 1

- [ ] Simulation of effect modules

## Wk 7 - Oct 8

- [ ] Protoboard all drum modules

## Wk 8 - Oct 15

- [ ] Protoboard all effect module

## Wk 9 - Oct 22

- [ ] Protoboard sequencer
- [ ] Make PCBs for module edge connectors

## Wk 10 - Oct 29

- [ ] Basic sequencer functionality
- [ ] Finalize bus connections (power, data, trigger, etc.)
  - [ ] sources
  - [ ] effects

## Wk 11 - Nov 5

- [ ] Effect bus functionality
  - [ ] Mixing
- [ ] Sequencer functionality continued

## Wk 12 - Nov 12

- [ ] PCB design of drum modules

## Wk 13 - Nov 19

- [ ] PCB design of effect modules

## Wk 14 - Nov 26

- [ ] PCB design of Sequencer
- [ ] PCB design of Mainboard
- [ ] Order PCBs

## Wk 15 - Dec 3

- [ ] Sequencer software Continued

## Wk 16 - Dec 10

- [ ] Sequencer software continued 

**end of semester**

----
