VegaDeftwing/AnalogDrumMachine/Journal/G165Minutes 210915.md

# G165 Minutes 21.09.15

**Attending:** Vega Carlson, Kaleb McQuillan, Reid Zimmerman, Cole Sirokman, Mark Bauer

---

**What you've done:**

Vega:

Worked with Pi-Pico to determine what micro controller to use

Kaleb:

Breadboarded an envelope generator circuit

Reid:

Breadborded a Snare Drum circuit

Cole:

Working on the 808 Kick and Tom circuits

---

## Minutes

11:00 Start of meeting

11:07 Discussion about a very large fuse and how fuses are rated

11:16 Discussion about buttons and encoders on the project

11:18 Reminder to journal regularly, and plead to submit more documents

11:25 Discussion about CNC/3D printing options for enclousures

11:30 Who's done what this week

## Action Items

(I, Vega, don't have the last set of action items for the last minutes, so this is from memory)

Vega:

- [ ] Continue bus structure and μC selection for sequncer - by Friday, September 17th 2021

Kaleb:

- [ ] Breadboard AR envelope gen - by Friday, September 17th 2021

Reid:

- [ ] Breadboard snare circuit using LiveSpice by Friday, September 17th 2021

Cole:

- [ ] Breadboard 808 kick and toms - by Friday, September 17th 2021

## Timeline

## Wk 1 - Aug 27

- [x] Basic project idea & outline
- [x] Get group on the same page about how a drum machine works

## Wk 2 - Sep 3

- [x] Project approval
- [x] Get analog circuit simulation working
- [x] Get at least one module simulated

## Wk 3 - Sep 10

- [x] Picking specific modules
  - [x] Sounds
  - [x] Effects
- [ ] Simulations of some drums

## Wk 4 - Sep 17

- [ ] ~~Order basic parts that we're certain on~~

  > Vega has most of these parts on hand

- [x] Simulation of half of the drum modules

## Wk 5 - Sep 24

- [ ] ~~Simulation of other half of drum modules~~
- [ ] Half of drum modules breadboarded
- [ ] Basic mock up of UI
  - [ ] Sequencer
  - [ ] Midi clocking

## Wk 6 - Oct 1

- [ ] Simulation of effect modules

## Wk 7 - Oct 8

- [ ] Protoboard all drum modules

## Wk 8 - Oct 15

- [ ] Protoboard all effect module

## Wk 9 - Oct 22

- [ ] Protoboard sequencer
- [ ] Make PCBs for module edge connectors

## Wk 10 - Oct 29

- [ ] Basic sequencer functionality
- [ ] Finalize bus connections (power, data, trigger, etc.)
  - [ ] sources
  - [ ] effects

## Wk 11 - Nov 5

- [ ] Effect bus functionality
  - [ ] Mixing
- [ ] Sequencer functionality continued

## Wk 12 - Nov 12

- [ ] PCB design of drum modules

## Wk 13 - Nov 19

- [ ] PCB design of effect modules

## Wk 14 - Nov 26

- [ ] PCB design of Sequencer
- [ ] PCB design of Mainboard
- [ ] Order PCBs

## Wk 15 - Dec 3

- [ ] Sequencer software Continued

## Wk 16 - Dec 10

- [ ] Sequencer software continued 

**end of semester**

----
