VegaDeftwing/AnalogDrumMachine/Journal/G165Minutes210903.md

# G165 Minutes 21.09.03

**Attending:** Vega Carlson, Kaleb McQuillan, Reid Zimmerman, Cole Sirokman

---

**What you've done:**

Vega:

- [x] Start looking into module options - by Friday, September 3rd 2021

  > Module selection - both sound generation and effects - are done. See `DrumSelection.md` and `EffectSelection.md` in the github repo. Also started figuring out what would be needed for the sequencer and the buses.

Kaleb:

- [x] Bass drum module research, finding a circuit to simulate - by Friday, September 3rd 2021

  > Looked into how a lot of the circuits work, mostly the bridged-T oscilator. Got the oscilator simulated, but not the envelope- started looking into desgins for enevolpes, using OpAmps mostly, in the hope to not just make an 808 clone.

Reid:

- [x] Trying out simulation software, finding what works best - by Friday, September 3rd 2021

  > Tried Simulink, started moving to KiCad for simulation. Still a bit unsure of what's best, but a working 808 bass drum has been made

Cole:

- [x] Bass drum module research, finding a circuit to simulate - by Friday, September 3rd 2021

  > Also simulated the 808 Bass Drum in Multisim, for sake of understanding the circuit better

---

## Minutes

3:25 Start of meeting

3:32 Review of what we've done this week

4:10 Discussion about the topology of an analog drum generator, difference of the Bridge-T and using a seperate oscillator, VCA, and Envelope

4:25 Determing action items and updating time line

## Action Items

Vega:

- [ ] Figure out bus structure and choose μC for sequncer - by Friday, September 10th 2021

Kaleb:

- [ ] Simulate an Attack/Decay envelope gen - by Friday, September 10th 2021

Reid:

- [ ] Simulate Snare Drum using LiveSpice by Friday, September 10th 2021

Cole:

- [ ] Simulate Toms using LiveSpice - by Friday, September 10th 2021

## Timeline

## Wk 1 - Aug 27

- [x] Basic project idea & outline
- [x] Get group on the same page about how a drum machine works

## Wk 2 - Sep 3

- [x] Project approval
- [x] Get analog ciricuit simulation working
- [x] Get at least one module simulated

## Wk 3 - Sep 10

- [x] Picking specific modules
  - [x] Sounds
  - [x] Effects
- [ ] Simulitions of some drums
- [ ] Bacic mock up of UI
  - [ ] Sequencer
  - [ ] Midi clocking

## Wk 4 - Sep 17

- [ ] Order basic parts that we're certain on
- [ ] Simulation of half of the drum modules

## Wk 5 - Sep 24

- [ ] Simulation of other half of drum modules

## Wk 6 - Oct 1

- [ ] Simulation of effect modules

## Wk 7 - Oct 8

- [ ] Protoboard all drum modules

## Wk 8 - Oct 15

- [ ] Protoboard all effect module

## Wk 9 - Oct 22

- [ ] Protoboard sequencer
- [ ] Make PCBs for module edge connectors

## Wk 10 - Oct 29

- [ ] Basic sequencer functionality
- [ ] Finalize bus connections (power, data, trigger, etc.)
  - [ ] sources
  - [ ] effects

## Wk 11 - Nov 5

- [ ] Effect bus functionality
  - [ ] Mixing
- [ ] Sequencer functionality continued

## Wk 12 - Nov 12

- [ ] PCB design of drum modules

## Wk 13 - Nov 19

- [ ] PCB design of effect modules

## Wk 14 - Nov 26

- [ ] PCB design of Sequencer
- [ ] PCB design of Mainboard
- [ ] Order PCBs

## Wk 15 - Dec 3

- [ ] Sequercer software contunied 

## Wk 16 - Dec 10

- [ ] Sequercer software contunied 

**end of semester**

----
