VegaDeftwing/AnalogDrumMachine/Journal/G165Minutes210901.md

# G165 Minutes 21.08.27
**Attending:** Vega Carlson, Kaleb McQuillan, Reid Zimmerman, Cole Sirokman, Mark Bauer

---

## What We've Done

Inital tasks have been assigned and will be reported on in Friday's Minutes

## Minutes

11:00 - Start of Meeting

11:07 - Discussion on how to take minutes. Format as proposed is identical to as perviously submitted except that action items should have percise dates, not just relative.

11:10 - Discussion about historical storage media

11:22 - Discussion about the project as proposed, including potential changes such as using a RaspberryPi and touch screen or e-ink instead of an OLED

11:30 - Remainder of time spent disussing DLP and LCD projector technology, sparked by conversation of "What is this part?" in regards to the micromirror device on the table

---

Timeline and action items remain unchanged from the Minutes from August 27th:

## Action Items

Vega:

- [ ] Start looking into module options - by Friday, September 3rd 2021

Kaleb:

- [ ] Bass drum module research, finding a circuit to simulate - by Friday, September 3rd 2021

Reid:

- [ ] Trying out simulation software, finding what works best - by Friday, September 3rd 2021

Cole:

- [ ] Bass drum module research, finding a circuit to simulate - by Friday, September 3rd 2021

## Timeline

## Wk 1 - Aug 27

- [ ] Basic project idea & outline
- [ ] Get group on the same page about how a drum machine works

## Wk 2 - Sep 3

- [ ] Project approval
- [ ] Get analog ciricuit simulation working
- [ ] Get at least one module simulated

## Wk 3 - Sep 10

- [ ] Order basic parts that we're certain on
- [ ] Picking specific modules
  - [ ] Sonuds
  - [ ] Effects
- [ ] Bacic mock up of UI
  - [ ] Sequencer
  - [ ] Midi clocking

## Wk 4 - Sep 17

- [ ] Simulation of half of the drum modules

## Wk 5 - Sep 24

- [ ] Simulation of other half of drum modules

## Wk 6 - Oct 1

- [ ] Simulation of effect modules

## Wk 7 - Oct 8

- [ ] Protoboard all drum modules

## Wk 8 - Oct 15

- [ ] Protoboard all effect module

## Wk 9 - Oct 22

- [ ] Protoboard sequencer
- [ ] Make PCBs for module edge connectors

## Wk 10 - Oct 29

- [ ] Basic sequencer functionality
- [ ] Finalize bus connections (power, data, trigger, etc.)
  - [ ] sources
  - [ ] effects

## Wk 11 - Nov 5

- [ ] Effect bus functionality
  - [ ] Mixing
- [ ] Sequencer functionality continued

## Wk 12 - Nov 12

- [ ] PCB design of drum modules

## Wk 13 - Nov 19

- [ ] PCB design of effect modules

## Wk 14 - Nov 26

- [ ] PCB design of Sequencer
- [ ] PCB design of Mainboard
- [ ] Order PCBs

## Wk 15 - Dec 3

- [ ] Sequercer software contunied 

## Wk 16 - Dec 10

- [ ] Sequercer software contunied 

**end of semester**

----
