VegaDeftwing/AnalogDrumMachine/Journal/G165Minutes210827.md

# G165 Minutes 21.08.27

**Attending:** Vega Carlson, Kaleb McQuillan, Reid Zimmerman, Cole Sirokman

**What you've done:**

Vega - Made intial mock up, looked into potential effects and synthesis ideas using Bucket Brigade Delays

Kaleb - Reasearched some about existing analog drum machines and past DIY projects

Reid - Read articles an drum circuits, gave feedback on mockup, exploring options for circuit simulation software

Cole - Read articles on drum machines, sequencing, etc. Looked into specific high level components (VCO, VCA, etc)

---

## Minutes

4:05 Group discussion about what a BBD

4:30 Basic discussion of project

5:00 Making Timeline

5:30 Showing off a working drum machine, so everyone gets the idea of how it works

## Action Items

Vega:

- [ ] Start looking into module options - by next Friday

Kaleb:

- [ ] Bass drum module research, finding a circuit to simulate - by next Friday

Reid:

- [ ] Trying out simulation software, finding what works best - by next Friday

Cole:

- [ ] Bass drum module research, finding a circuit to simulate - by next Friday

## Timeline

## Wk 1 - Aug 27

- [ ] Basic project idea & outline
- [ ] Get group on the same page about how a drum machine works

## Wk 2 - Sep 3

- [ ] Project approval
- [ ] Get analog ciricuit simulation working
- [ ] Get at least one module simulated

## Wk 3 - Sep 10

- [ ] Order basic parts that we're certain on
- [ ] Picking specific modules
  - [ ] Sonuds
  - [ ] Effects
- [ ] Bacic mock up of UI
  - [ ] Sequencer
  - [ ] Midi clocking

## Wk 4 - Sep 17

- [ ] Simulation of half of the drum modules

## Wk 5 - Sep 24

- [ ] Simulation of other half of drum modules

## Wk 6 - Oct 1

- [ ] Simulation of effect modules

## Wk 7 - Oct 8

- [ ] Protoboard all drum modules

## Wk 8 - Oct 15

- [ ] Protoboard all effect module

## Wk 9 - Oct 22

- [ ] Protoboard sequencer
- [ ] Make PCBs for module edge connectors

## Wk 10 - Oct 29

- [ ] Basic sequencer functionality
- [ ] Finalize bus connections (power, data, trigger, etc.)
  - [ ] sources
  - [ ] effects

## Wk 11 - Nov 5

- [ ] Effect bus functionality
  - [ ] Mixing
- [ ] Sequencer functionality continued

## Wk 12 - Nov 12

- [ ] PCB design of drum modules

## Wk 13 - Nov 19

- [ ] PCB design of effect modules

## Wk 14 - Nov 26

- [ ] PCB design of Sequencer
- [ ] PCB design of Mainboard
- [ ] Order PCBs

## Wk 15 - Dec 3

- [ ] Sequercer software contunied 

## Wk 16 - Dec 10

- [ ] Sequercer software contunied 

**end of semester**

----
