VegaDeftwing/AnalogDrumMachine/Journal/VegaCarlsonJournalFall21w02.md

# Vega Carlson - Group 165 - Fall '21, Week 2

## Saturday, Aug 7th -- W:0.00 T:9.50

**0.00 hr** Talkd to group a bit in short intervals while they worked. Found some PDFs related to the project and sent them in our chat, but otherwise didn't do anything. Counting this as 0-time 

## Sunday, Aug 8th -- W:0.00 T:9.50

**0.00hr** Did not work on the project today

## Monday, Aug 9th -- W:2.50 T:12.00 

**2.5 hr** Researched what drum modules would be reasonable to move forward with. As of now the plan is to make a kick drum, snare drum, hi-hat, FM-voice, Karplus-Strong (or similar) voice, sample based (SD card), Toms (with low, mid, high), and a fake-sidechained voice. More details on these choices can be found in `DrumSelection.md` in the [project's GitHub repository](https://github.com/VegaDeftwing/AnalogDrumMachine).

## Tuesday, Aug 10th -- W:4.00 T:13.50

**1.5hr** Researched what effect modules would be best to move forward with. As of now the plan is to have fixed volume, filter, and compression effects along with delay, comb filtering, sample rate and bit-depth reduction, and distortion modules. More details on these choices can be found in `EffectSelection.md` in the [project's GitHub repository](https://github.com/VegaDeftwing/AnalogDrumMachine).

## Wednesday, Aug 11th -- W:6.00 T:15.50

**0.5hr** Group meeting with Bauer, discussed project overview, talked about some interesting parts

**1.5hr** Thought about how to impliment the sequncer and busses from a high level, there's still a lot of thinking to be done. see `SequencerAndBusSelection.md` in the [project's GitHub repository](https://github.com/VegaDeftwing/AnalogDrumMachine).

## Thursday, Aug 12th -- W:6.50 T:16.00

**0.5hr** Continued work on  `SequencerAndBusSelection.md` in the [project's GitHub repository](https://github.com/VegaDeftwing/AnalogDrumMachine).

## Friday, Aug 13th -- W:8.00 T:17.50

**1hr** Meeting with group

**0.5hr** reading up on the TR-808 Bass Drum circuit, to try to follow along with group members while we're still working on otherwise seperate tasks

---

**Week ending 8/27 total = 8.0hrs**
