VegaDeftwing/AnalogDrumMachine/PCBs/Delay PCB/delayEffect/delayEffect.kicad_pcb

## KiCad design PCBs/Delay PCB/delayEffect/delayEffect.kicad_pcb (2022-04-01)

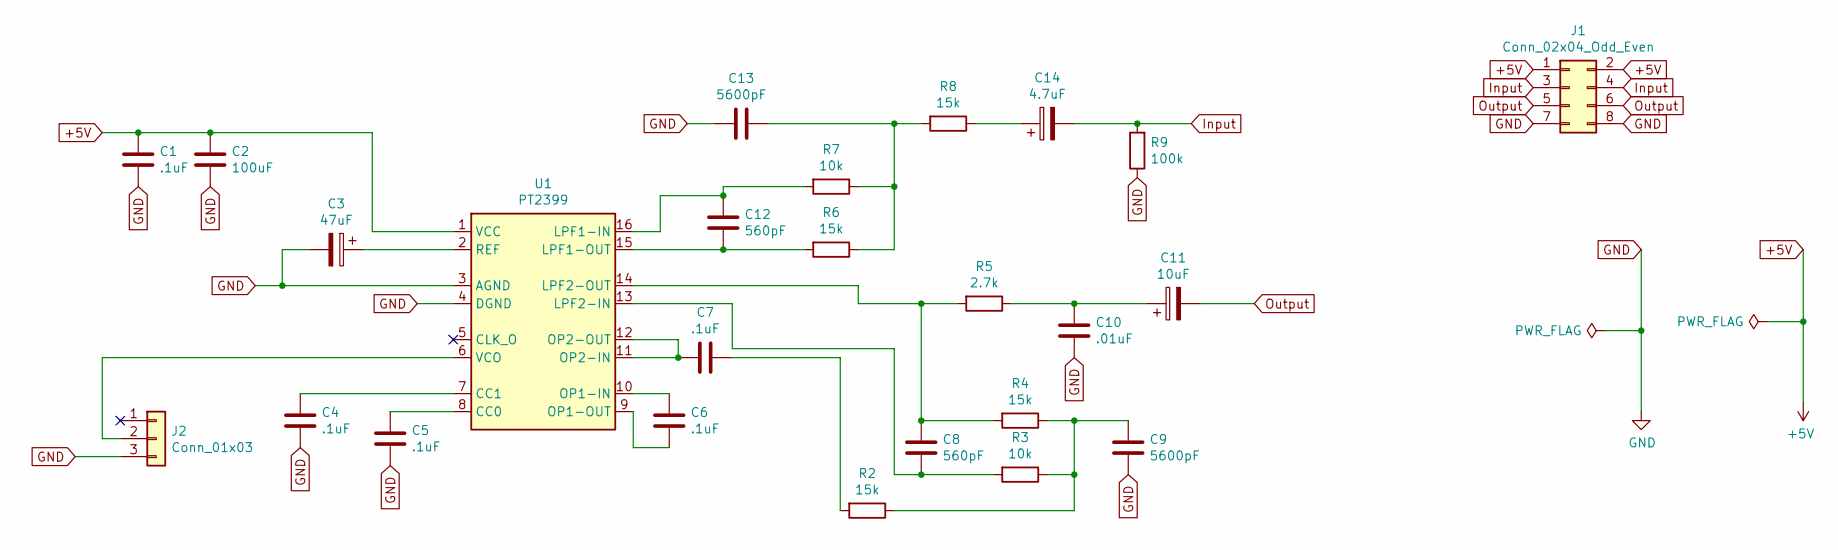
[picture p44: schematic delayEffect.sch]

Parts:
C1, C4, C5, C6, C7: .1uF; C_0805_2012Metric
C2: 100uF; CP_Radial_D5.0mm_P2.00mm
C3: 47uF; CP_Radial_D5.0mm_P2.00mm
C8, C12: 560pF; C_0805_2012Metric
C9, C13: 5600pF; C_0805_2012Metric
C10: .01uF; C_0805_2012Metric
C11: 10uF; C_0805_2012Metric
C14: 4.7uF; CP_Radial_D5.0mm_P2.00mm
J1: Conn_02x04_Odd_Even; PinHeader_2x04_P2.54mm_Vertical
J2: Conn_01x03; PinHeader_1x03_P2.54mm_Vertical
R2, R4, R6, R8: 15k; R_0805_2012Metric
R3, R7: 10k; R_0805_2012Metric
R5: 2.7k; R_0805_2012Metric
R9: 100k; R_0805_2012Metric
U1: PT2399; DIP-16_W7.62mm_Socket

Connections:
+5V: C1.1, C2.1, J1.1, J1.2, U1.1 (VCC)
GND: C1.2, C2.2, C3.2, C4.2, C5.2, C9.2, C10.2, C13.2, J1.7, J1.8, J2.3, R9.1, U1.3 (AGND), U1.4 (DGND)
Input: C14.2, J1.3, J1.4, R9.2
unnamed: C3.1, U1.2 (REF)
unnamed: C4.1, U1.7 (CC1)
unnamed: C5.1, U1.8 (CC0)
unnamed: C6.1, U1.10 (OP1-IN)
unnamed: C6.2, U1.9 (OP1-OUT)
unnamed: C7.1, R2.2
unnamed: C7.2, U1.11 (OP2-IN), U1.12 (OP2-OUT)
unnamed: C8.1, R4.2, R5.2, U1.14 (LPF2-OUT)
unnamed: C8.2, R3.2, U1.13 (LPF2-IN)
unnamed: C9.1, R2.1, R3.1, R4.1
unnamed: C10.1, C11.1, R5.1
unnamed: C12.1, R7.2, U1.16 (LPF1-IN)
unnamed: C12.2, R6.2, U1.15 (LPF1-OUT)
unnamed: C13.1, R6.1, R7.1, R8.2
unnamed: C14.1, R8.1
unnamed: J2.2, U1.6 (VCO)
Output: C11.2, J1.5, J1.6

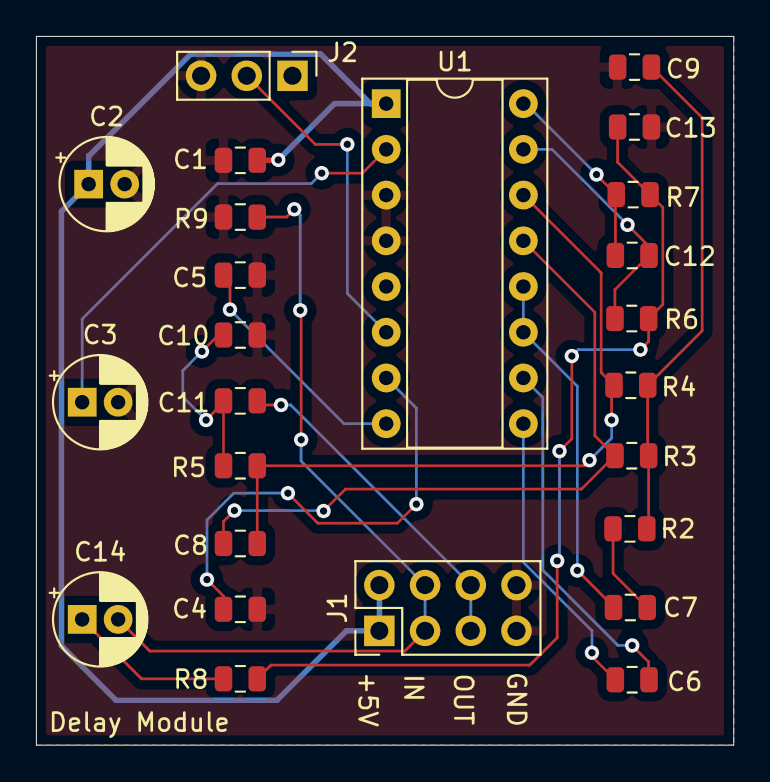
[picture p45: board delayEffect.kicad_pcb from above]

Board: 2 copper layers, 38.7 x 39.4 mm, 25 parts (0 on the bottom side), 20 nets.
