VegaDeftwing/AnalogDrumMachine/PCBs/ECEN494 KiCAD/HIHAT/Hihat/Hihat.kicad_pcb

## KiCad design PCBs/ECEN494 KiCAD/HIHAT/Hihat/Hihat.kicad_pcb (2022-05-05)

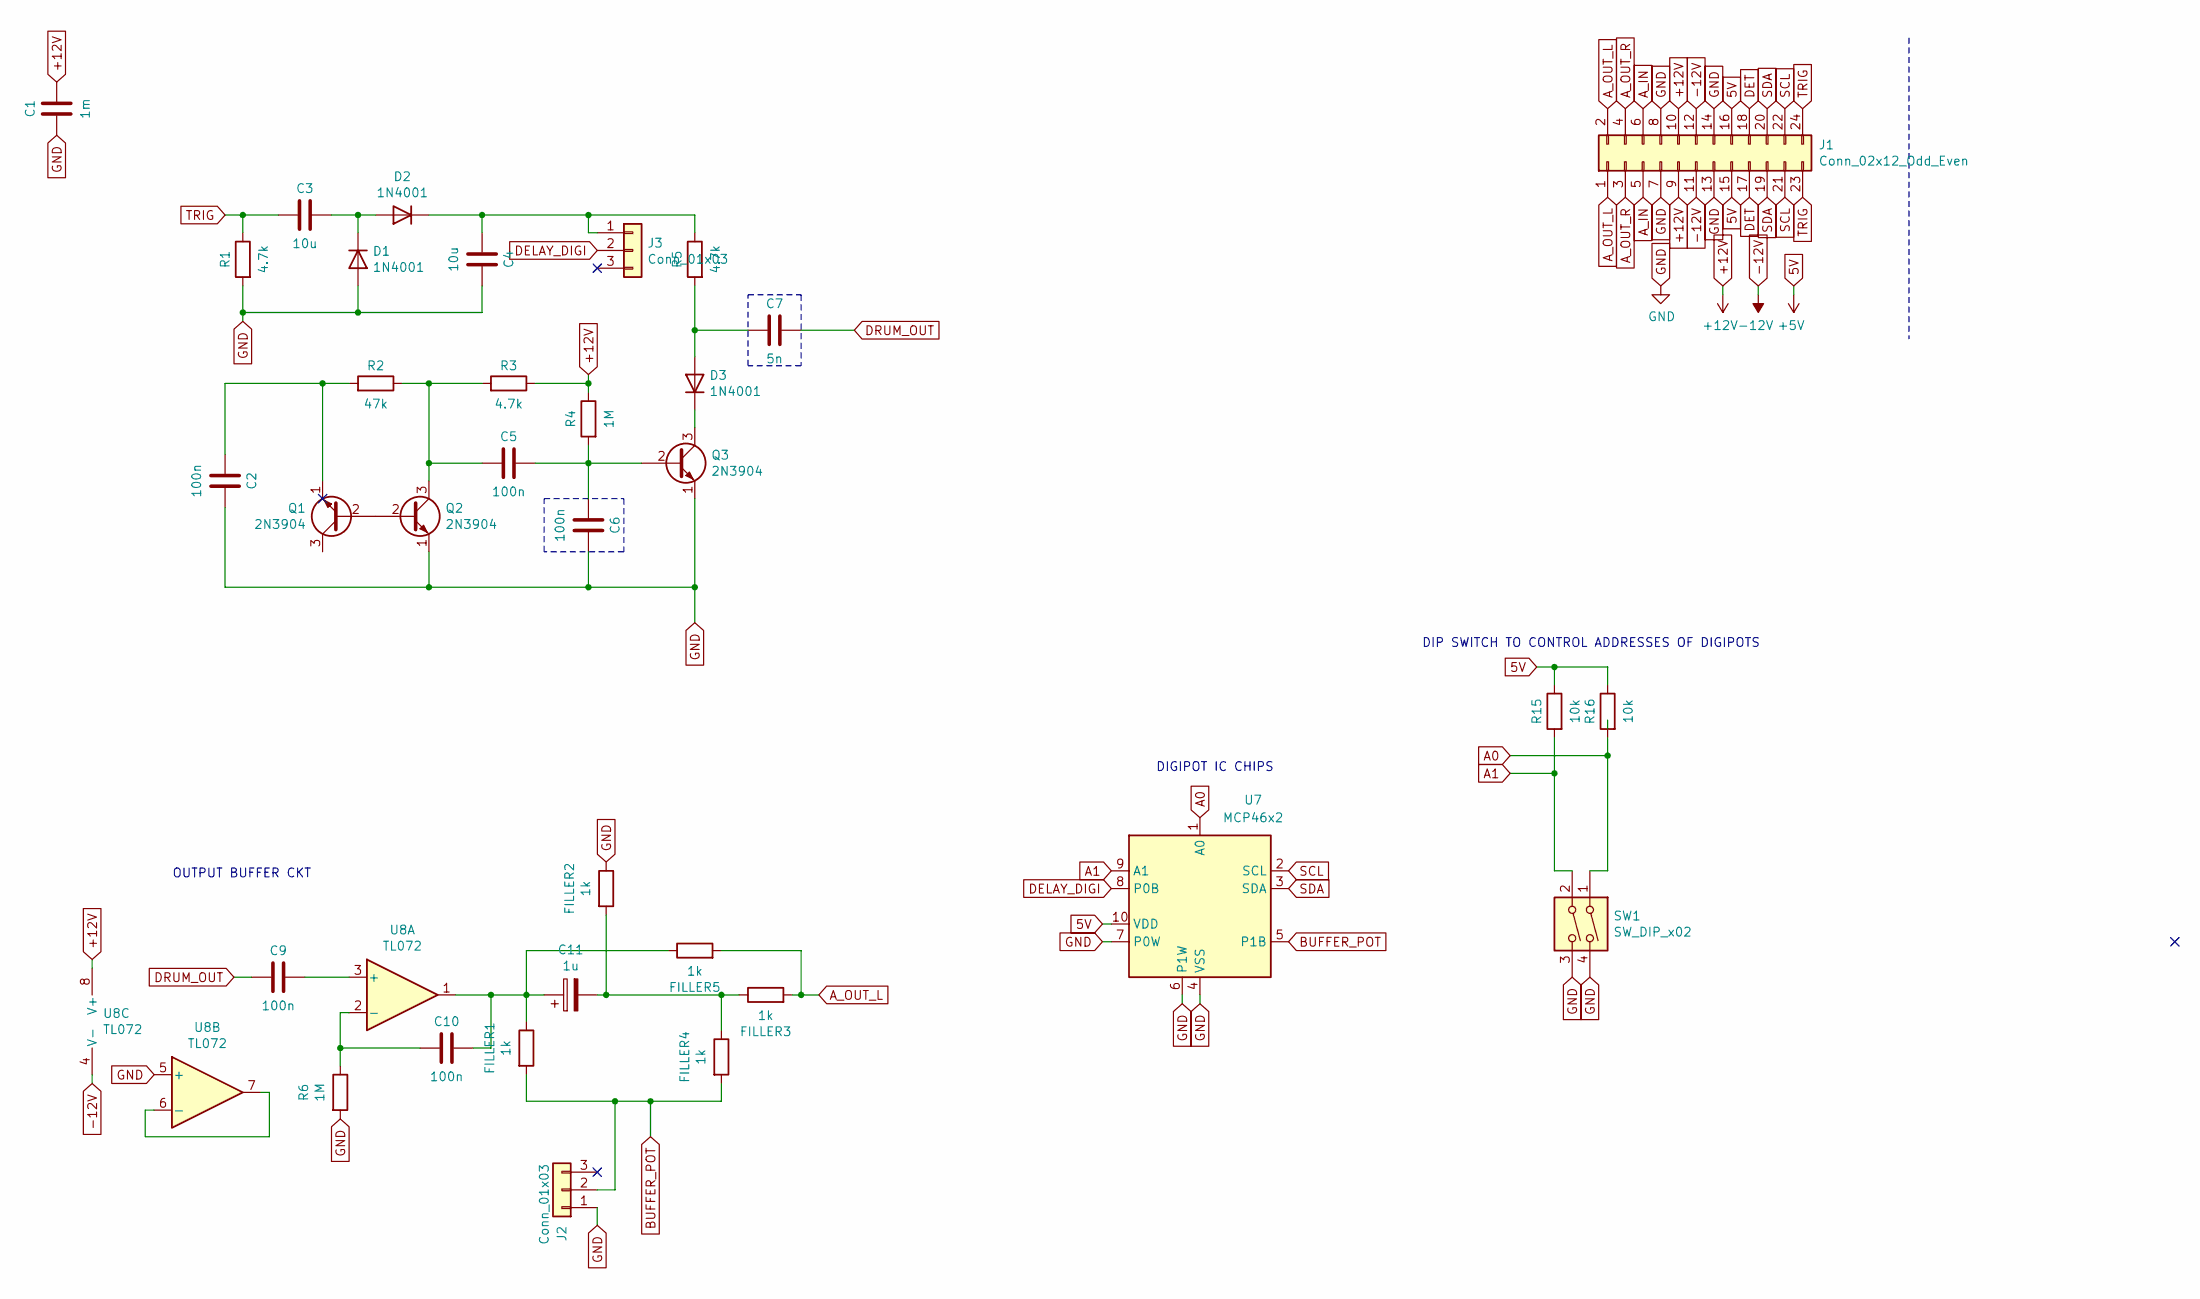
[picture p46: schematic Hihat.sch]

Parts:
C1: 1m; C_Disc_D7.0mm_W2.5mm_P5.00mm
C2, C5, C6, C9, C10: 100n; C_Disc_D7.0mm_W2.5mm_P5.00mm
C3, C4: 10u; C_Disc_D7.0mm_W2.5mm_P5.00mm
C7: 5n; C_Disc_D7.0mm_W2.5mm_P5.00mm
C11: 1u; C_Disc_D7.0mm_W2.5mm_P5.00mm
D1, D2, D3: 1N4001; D_DO-41_SOD81_P10.16mm_Horizontal
FILLER1, FILLER2, FILLER3, FILLER4, FILLER5: 1k; R_Axial_DIN0207_L6.3mm_D2.5mm_P10.16mm_Horizontal
J1: Conn_02x12_Odd_Even; PinSocket_2x12_P2.54mm_Vertical
J2, J3: Conn_01x03; PinSocket_1x03_P2.54mm_Vertical
Q1, Q2, Q3: 2N3904; TO-92_Inline
R1, R3, R5: 4.7k; R_Axial_DIN0207_L6.3mm_D2.5mm_P10.16mm_Horizontal
R2: 47k; R_Axial_DIN0207_L6.3mm_D2.5mm_P10.16mm_Horizontal
R4, R6: 1M; R_Axial_DIN0207_L6.3mm_D2.5mm_P10.16mm_Horizontal
R15, R16: 10k; R_Axial_DIN0207_L6.3mm_D2.5mm_P10.16mm_Horizontal
SW1: SW_DIP_x02; SW_DIP_SPSTx02_Slide_6.7x6.64mm_W7.62mm_P2.54mm_LowProfile
U7: MCP46x2; MSOP-10_3x3mm_P0.5mm
U8: TL072; SO-8_5.3x6.2mm_P1.27mm

Connections:
5V: J1.15, J1.16, R15.1, R16.1, U7.10 (VDD)
+12V: C1.2, J1.9, J1.10, R3.1, R4.1, U8.8 (V+)
-12V: J1.11, J1.12, U8.4 (V-)
A0: R16.2, SW1.1, U7.1 (A0)
A1: R15.2, SW1.2, U7.9 (A1)
A_IN: J1.5, J1.6
A_OUT_L: FILLER3.2, FILLER5.2, J1.1, J1.2
A_OUT_R: J1.3, J1.4
BUFFER_POT: FILLER1.2, FILLER4.2, J2.2, U7.5 (P1B)
DELAY_DIGI: J3.2, U7.8 (P0B)
DET: J1.17, J1.18
DRUM_OUT: C7.2, C9.1
GND: C1.1, C2.2, C4.2, C6.2, D1.2 (A), FILLER2.1, J1.7, J1.8, J1.13, J1.14, J2.1, Q2.1 (E), Q3.1 (E), R1.2, R6.2, SW1.3, SW1.4, U7.4 (VSS), U7.6 (P1W), U7.7 (P0W), U8.5 (+)
unnamed: C2.1, Q1.1 (E), R2.2
unnamed: C3.2, D1.1 (K), D2.2 (A)
unnamed: C4.1, D2.1 (K), J3.1, R5.1
unnamed: C5.1, Q2.3 (C), R2.1, R3.2
unnamed: C5.2, C6.1, Q3.2 (B), R4.2
unnamed: C7.1, D3.2 (A), R5.2
unnamed: C9.2, U8.3 (+)
unnamed: C10.1, R6.1, U8.2 (-)
unnamed: C10.2, C11.1, FILLER1.1, FILLER5.1, U8.1
unnamed: C11.2, FILLER2.2, FILLER3.1, FILLER4.1
unnamed: D3.1 (K), Q3.3 (C)
unnamed: Q1.2 (B), Q2.2 (B)
unnamed: U8.6 (-), U8.7
SCL: J1.21, J1.22, U7.2 (SCL)
SDA: J1.19, J1.20, U7.3 (SDA)
TRIG: C3.1, J1.23, J1.24, R1.1

Notes on the sheet:
OUTPUT BUFFER CKT
DIGIPOT IC CHIPS
DIP SWITCH TO CONTROL ADDRESSES OF DIGIPOTS

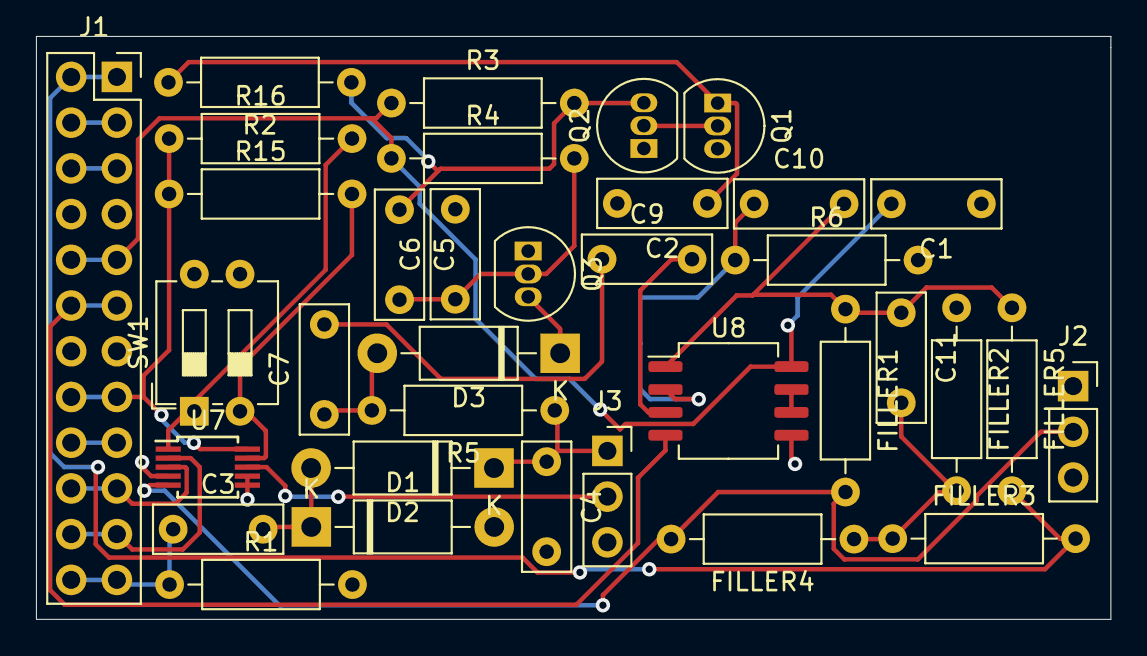
[picture p47: board Hihat.kicad_pcb from above]

Board: 2 copper layers, 59.7 x 32.4 mm, 35 parts (0 on the bottom side), 29 nets.
