VegaDeftwing/AnalogDrumMachine/PCBs/ECEN494 KiCAD/FM/FM DRUM/dddd/dddd.kicad_pcb

## KiCad design PCBs/ECEN494 KiCAD/FM/FM DRUM/dddd/dddd.kicad_pcb (2022-05-05)

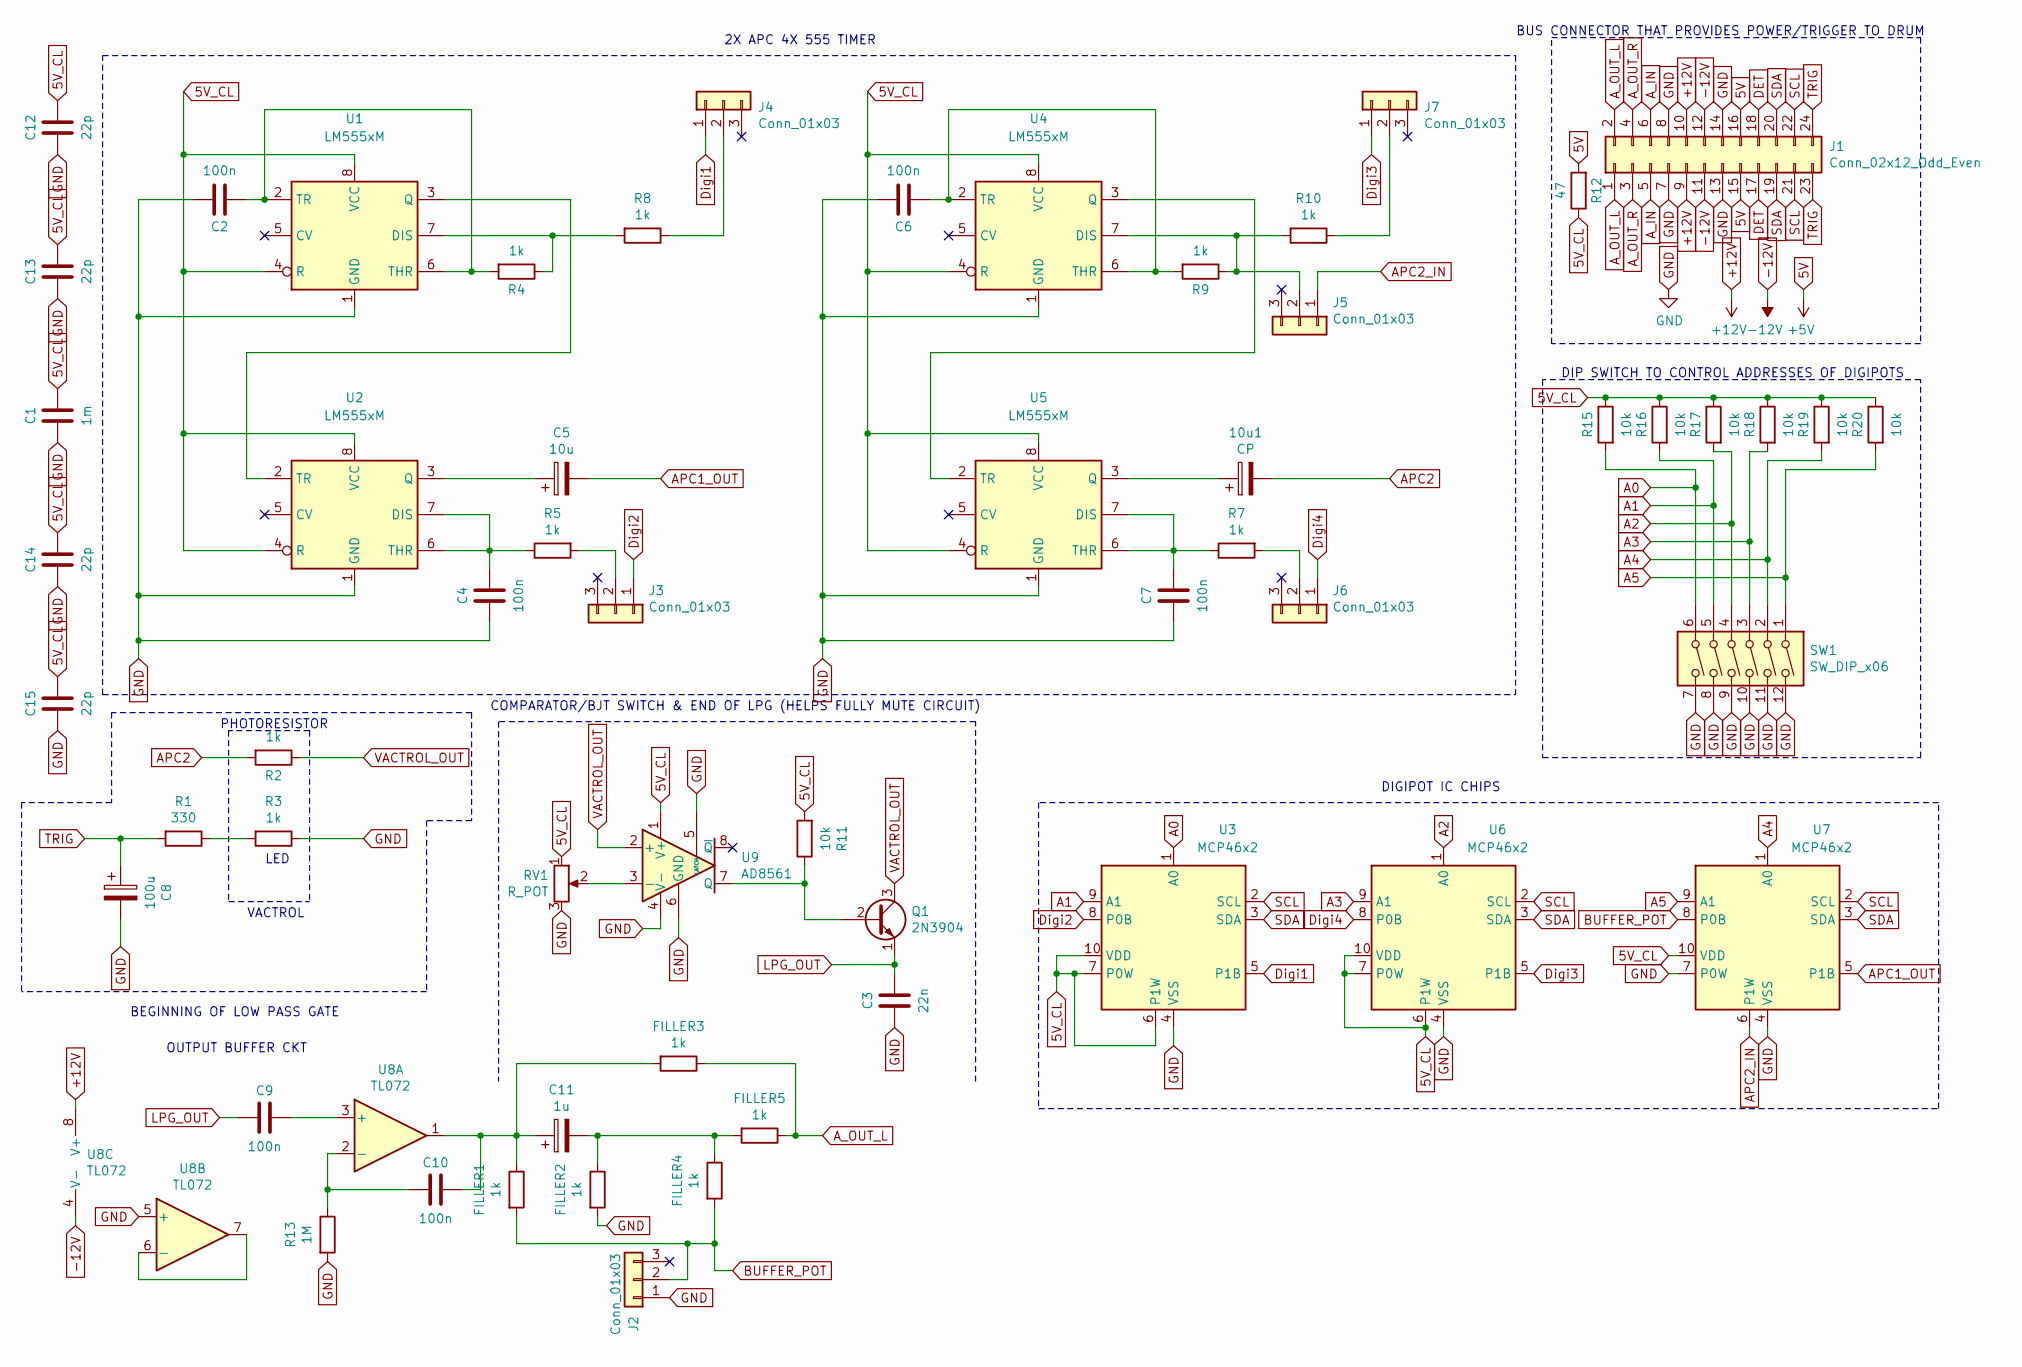
[picture p48: schematic dddd.sch]

Parts:
10u1: CP; C_Disc_D7.0mm_W2.5mm_P5.00mm
C1: 1m; C_Disc_D7.0mm_W2.5mm_P5.00mm
C2, C4, C6, C7, C9, C10: 100n; C_Disc_D7.0mm_W2.5mm_P5.00mm
C3: 22n; C_Disc_D7.0mm_W2.5mm_P5.00mm
C5: 10u; C_Disc_D7.0mm_W2.5mm_P5.00mm
C8: 100u; C_Disc_D7.0mm_W2.5mm_P5.00mm
C11: 1u; C_Disc_D7.0mm_W2.5mm_P5.00mm
C12, C13, C14, C15: 22p; C_Disc_D7.0mm_W2.5mm_P5.00mm
FILLER1, FILLER2, FILLER3, FILLER4, FILLER5: 1k; R_Axial_DIN0207_L6.3mm_D2.5mm_P10.16mm_Horizontal
J1: Conn_02x12_Odd_Even; PinSocket_2x12_P2.54mm_Vertical
J2, J3, J4, J5, J6, J7: Conn_01x03; PinSocket_1x03_P2.54mm_Vertical
Q1: 2N3904; PinSocket_1x03_P2.54mm_Vertical
R1: 330; R_Axial_DIN0207_L6.3mm_D2.5mm_P10.16mm_Horizontal
R2, R3, R4, R5, R7, R8, R9, R10: 1k; R_Axial_DIN0207_L6.3mm_D2.5mm_P10.16mm_Horizontal
R11, R15, R16, R17, R18, R19, R20: 10k; R_Axial_DIN0207_L6.3mm_D2.5mm_P10.16mm_Horizontal
R12: 47; R_Axial_DIN0207_L6.3mm_D2.5mm_P10.16mm_Horizontal
R13: 1M; R_Axial_DIN0207_L6.3mm_D2.5mm_P10.16mm_Horizontal
RV1: R_POT; Potentiometer_Piher_PT-6-V_Vertical
SW1: SW_DIP_x06; SW_DIP_SPSTx06_Slide_6.7x16.8mm_W7.62mm_P2.54mm_LowProfile
U1, U2, U4, U5: LM555xM; DIP-8_W7.62mm
U3, U6, U7: MCP46x2; MSOP-10_3x3mm_P0.5mm
U8: TL072; SO-8_5.3x6.2mm_P1.27mm
U9: AD8561; DIP-8_W7.62mm

Connections:
5V: J1.15, J1.16, R12.2
5V_CL: C1.2, C12.2, C13.2, C14.2, C15.2, R11.2, R12.1, R15.1, R16.1, R17.1, R18.1, R19.1, R20.1, RV1.1, U1.4 (R), U1.8 (VCC), U2.4 (R), U2.8 (VCC), U3.6 (P1W), U3.7 (P0W), U3.10 (VDD), U4.4 (R), U4.8 (VCC), U5.4 (R), U5.8 (VCC), U6.6 (P1W), U6.7 (P0W), U6.10 (VDD), U7.10 (VDD), U9.1 (V+)
+12V: J1.9, J1.10, U8.8 (V+)
-12V: J1.11, J1.12, U8.4 (V-)
A0: R15.2, SW1.6, U3.1 (A0)
A1: R16.2, SW1.5, U3.9 (A1)
A2: R17.2, SW1.4, U6.1 (A0)
A3: R18.2, SW1.3, U6.9 (A1)
A4: R19.2, SW1.2, U7.1 (A0)
A5: R20.2, SW1.1, U7.9 (A1)
APC1_OUT: C5.2, U7.5 (P1B)
APC2: 10u1.2, R2.2
APC2_IN: J5.1, U7.6 (P1W)
A_IN: J1.5, J1.6
A_OUT_L: FILLER3.1, FILLER5.1, J1.1, J1.2
A_OUT_R: J1.3, J1.4
BUFFER_POT: FILLER1.2, FILLER4.2, J2.2, U7.8 (P0B)
DET: J1.17, J1.18
Digi1: J4.1, U3.5 (P1B)
Digi2: J3.1, U3.8 (P0B)
Digi3: J7.1, U6.5 (P1B)
Digi4: J6.1, U6.8 (P0B)
GND: C1.1, C2.2, C3.1, C4.1, C6.2, C7.1, C8.2, C12.1, C13.1, C14.1, C15.1, FILLER2.2, J1.7, J1.8, J1.13, J1.14, J2.1, R3.1, R13.2, RV1.3, SW1.7, SW1.8, SW1.9, SW1.10, SW1.11, SW1.12, U1.1 (GND), U2.1 (GND), U3.4 (VSS), U4.1 (GND), U5.1 (GND), U6.4 (VSS), U7.4 (VSS), U7.7 (P0W), U8.5 (+), U9.4 (V-), U9.5 (LATCH), U9.6 (GND)
LPG_OUT: C3.2, C9.1, Q1.1 (E)
unnamed: 10u1.1, U5.3 (Q)
unnamed: C2.1, R4.2, U1.2 (TR), U1.6 (THR)
unnamed: C4.2, R5.1, U2.6 (THR), U2.7 (DIS)
unnamed: C5.1, U2.3 (Q)
unnamed: C6.1, R9.2, U4.2 (TR), U4.6 (THR)
unnamed: C7.2, R7.1, U5.6 (THR), U5.7 (DIS)
unnamed: C9.2, U8.3 (+)
unnamed: C10.1, R13.1, U8.2 (-)
unnamed: C10.2, C11.1, FILLER1.1, FILLER3.2, U8.1
unnamed: C11.2, FILLER2.1, FILLER4.1, FILLER5.2
unnamed: J3.2, R5.2
unnamed: J4.2, R8.1
unnamed: J5.2, R9.1, R10.2, U4.7 (DIS)
unnamed: J6.2, R7.2
unnamed: J7.2, R10.1
unnamed: Q1.2 (B), R11.1, U9.7 (Q)
unnamed: R1.1, R3.2
unnamed: R4.1, R8.2, U1.7 (DIS)
unnamed: RV1.2, U9.3 (-)
unnamed: U1.3 (Q), U2.2 (TR)
unnamed: U4.3 (Q), U5.2 (TR)
unnamed: U8.6 (-), U8.7
SCL: J1.21, J1.22, U3.2 (SCL), U6.2 (SCL), U7.2 (SCL)
SDA: J1.19, J1.20, U3.3 (SDA), U6.3 (SDA), U7.3 (SDA)
TRIG: C8.1, J1.23, J1.24, R1.2
VACTROL_OUT: Q1.3 (C), R2.1, U9.2 (+)

Notes on the sheet:
BEGINNING OF LOW PASS GATE
OUTPUT BUFFER CKT
PHOTORESISTOR
VACTROL
LED
COMPARATOR/BJT SWITCH & END OF LPG (HELPS FULLY MUTE CIRCUIT)
2X APC 4X 555 TIMER
DIGIPOT IC CHIPS
BUS CONNECTOR THAT PROVIDES POWER/TRIGGER TO DRUM
DIP SWITCH TO CONTROL ADDRESSES OF DIGIPOTS

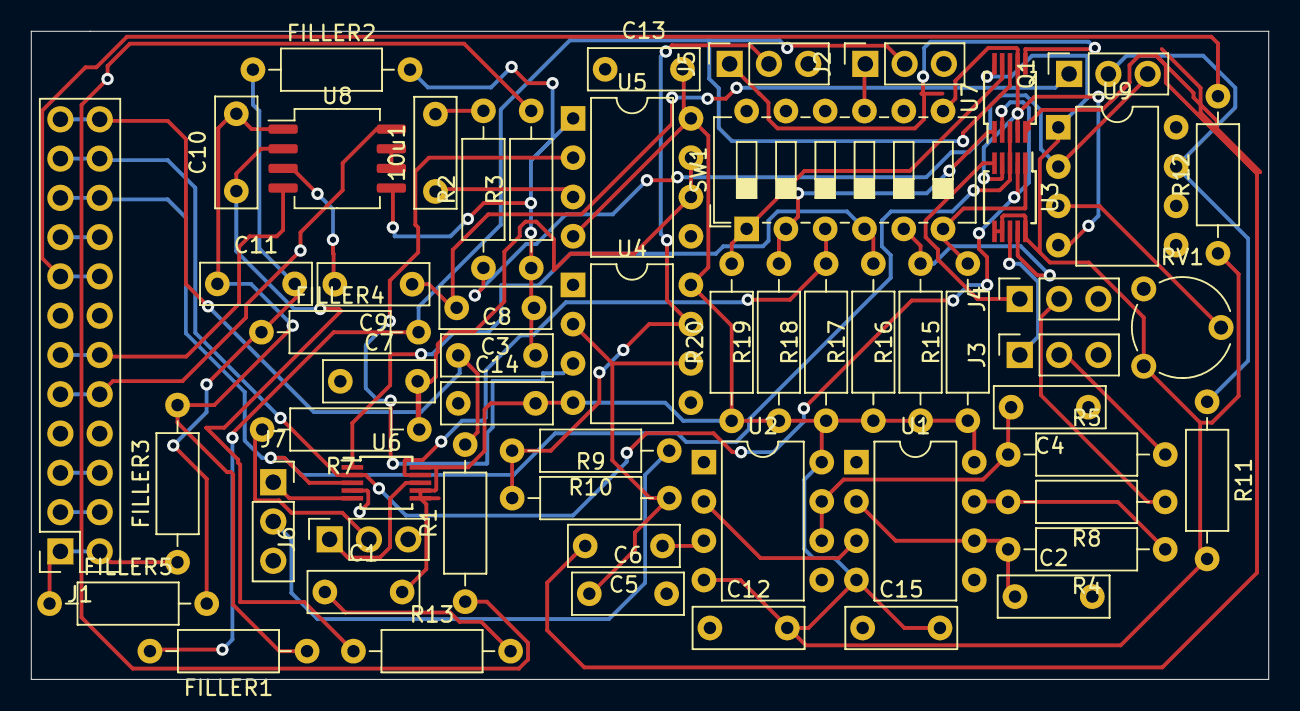
[picture p49: board dddd.kicad_pcb from above]

Board: 2 copper layers, 80.0 x 41.9 mm, 58 parts (0 on the bottom side), 50 nets.
