VegaDeftwing/AnalogDrumMachine/PCBs/ECEN494 KiCAD/Snare/Snare_For_Reid_Rev1.kicad_pcb

## KiCad design PCBs/ECEN494 KiCAD/Snare/Snare_For_Reid_Rev1.kicad_pcb (2022-04-15)

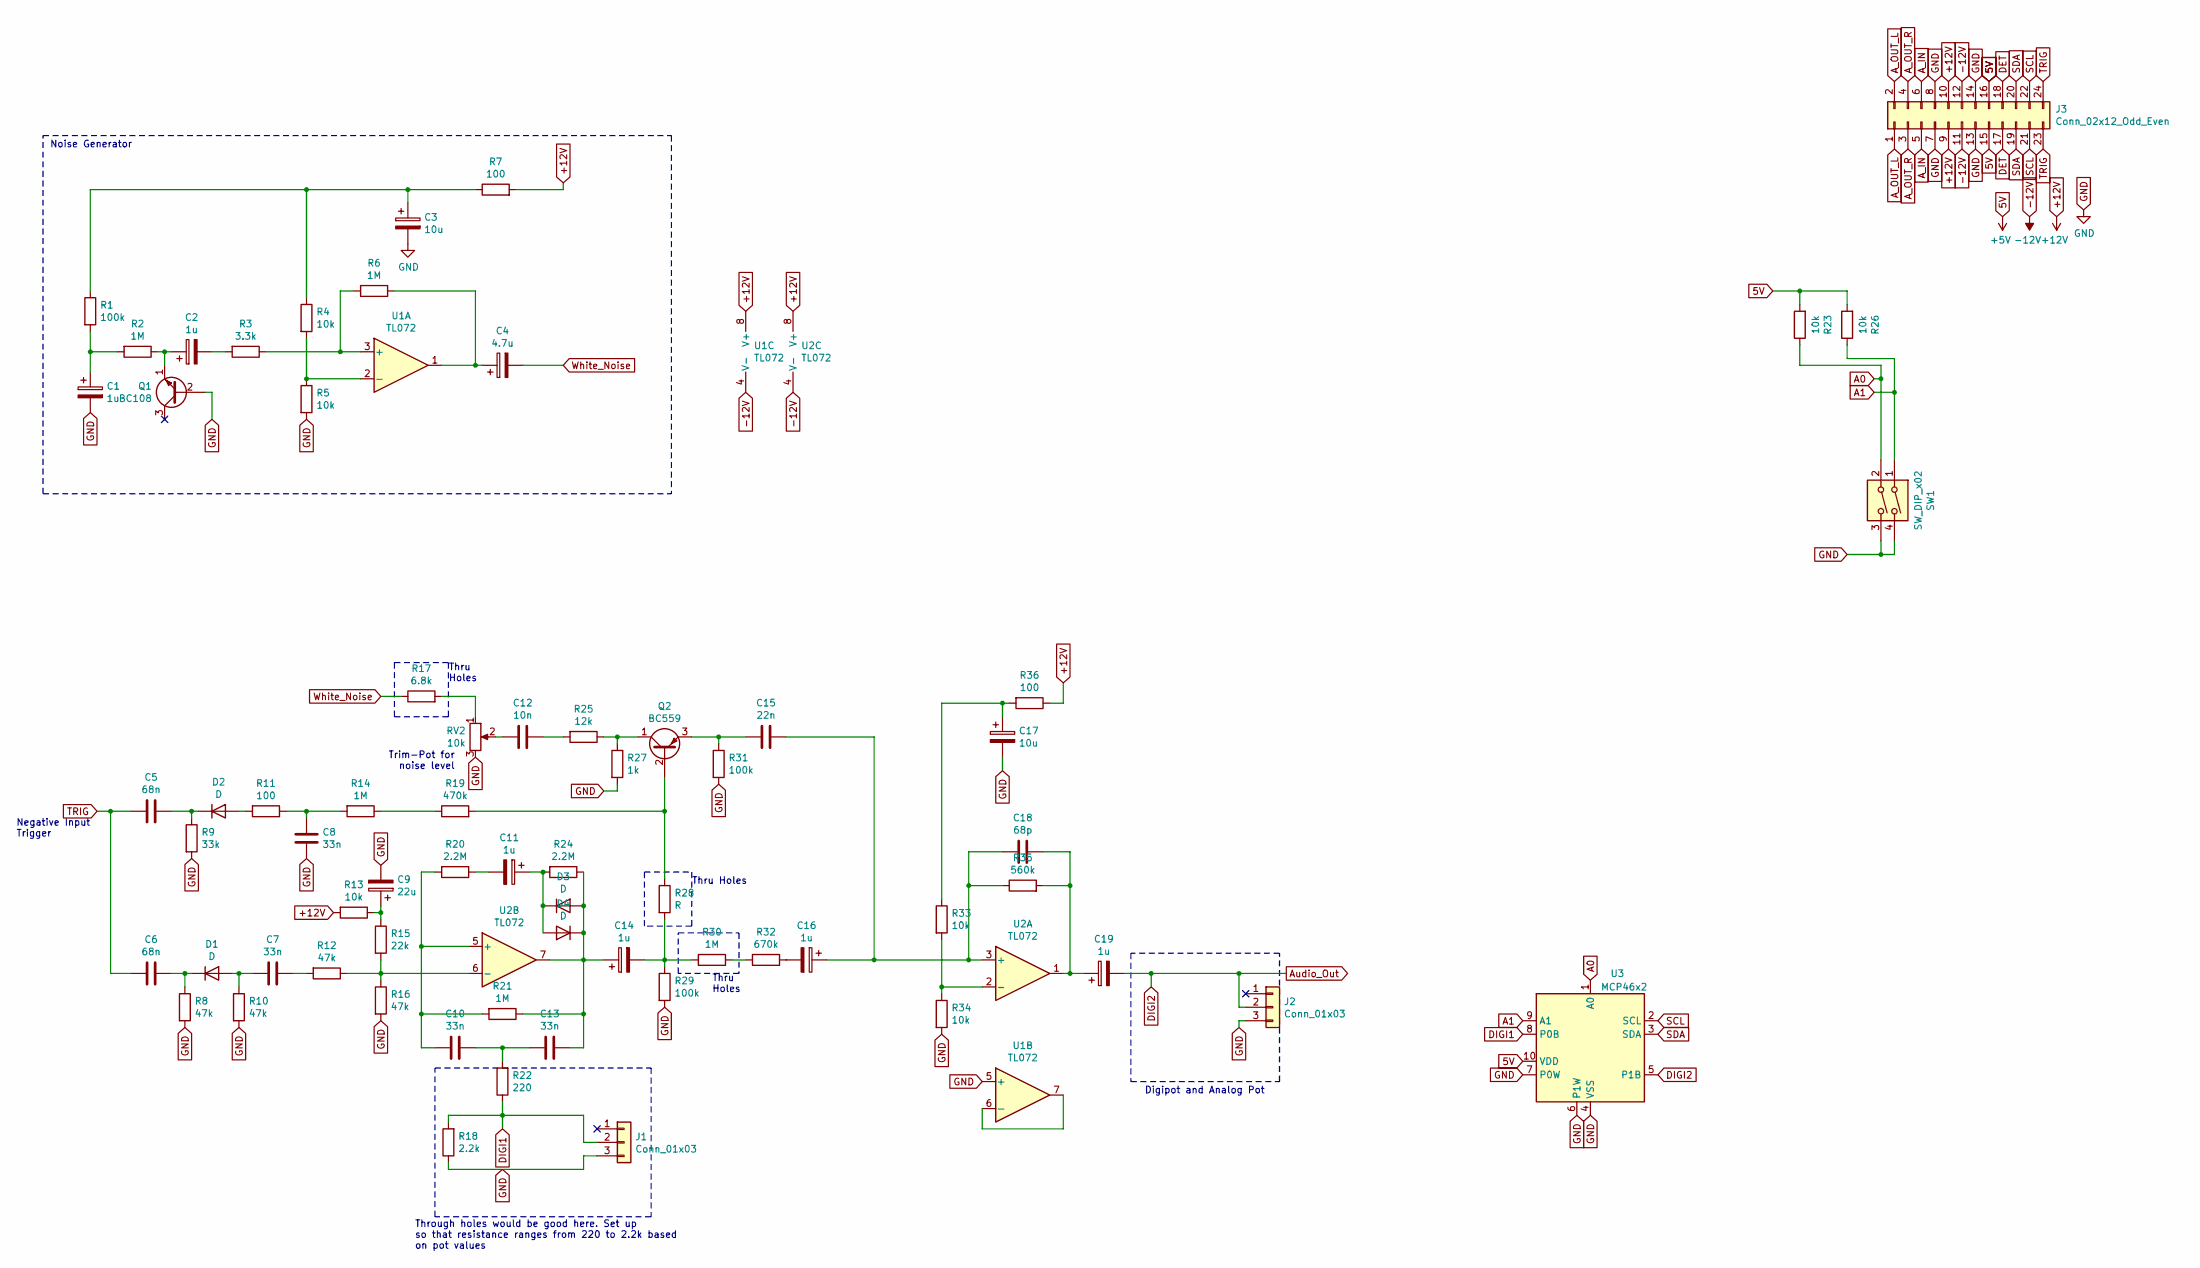
[picture p50: schematic Snare_For_Reid_Rev1.sch]

Parts:
C1, C2, C11, C14, C16, C19: 1u; C_Disc_D7.0mm_W2.5mm_P5.00mm
C3, C17: 10u; C_Disc_D7.0mm_W2.5mm_P5.00mm
C4: 4.7u; C_Disc_D7.0mm_W2.5mm_P5.00mm
C5, C6: 68n; C_Disc_D7.0mm_W2.5mm_P5.00mm
C7, C8, C10, C13: 33n; C_Disc_D7.0mm_W2.5mm_P5.00mm
C9: 22u; C_Disc_D7.0mm_W2.5mm_P5.00mm
C12: 10n; C_Disc_D7.0mm_W2.5mm_P5.00mm
C15: 22n; C_Disc_D7.0mm_W2.5mm_P5.00mm
C18: 68p; C_Disc_D7.0mm_W2.5mm_P5.00mm
D1, D2, D3, D4: D; R_Axial_DIN0207_L6.3mm_D2.5mm_P10.16mm_Horizontal
J1, J2: Conn_01x03; PinSocket_1x03_P2.54mm_Vertical
J3: Conn_02x12_Odd_Even; PinSocket_2x12_P2.54mm_Vertical
Q1: BC108; TO-18-3
Q2: BC559; TO-92_Inline
R1, R29, R31: 100k; R_Axial_DIN0207_L6.3mm_D2.5mm_P10.16mm_Horizontal
R2, R6, R14, R21, R30: 1M; R_Axial_DIN0207_L6.3mm_D2.5mm_P10.16mm_Horizontal
R3: 3.3k; R_Axial_DIN0207_L6.3mm_D2.5mm_P10.16mm_Horizontal
R4, R5, R13, R23, R26, R33, R34: 10k; R_Axial_DIN0207_L6.3mm_D2.5mm_P10.16mm_Horizontal
R7, R11, R36: 100; R_Axial_DIN0207_L6.3mm_D2.5mm_P10.16mm_Horizontal
R8, R10, R12, R16: 47k; R_Axial_DIN0207_L6.3mm_D2.5mm_P10.16mm_Horizontal
R9: 33k; R_Axial_DIN0207_L6.3mm_D2.5mm_P10.16mm_Horizontal
R15: 22k; R_Axial_DIN0207_L6.3mm_D2.5mm_P10.16mm_Horizontal
R17: 6.8k; R_Axial_DIN0207_L6.3mm_D2.5mm_P10.16mm_Horizontal
R18: 2.2k; R_Axial_DIN0207_L6.3mm_D2.5mm_P10.16mm_Horizontal
R19: 470k; R_Axial_DIN0207_L6.3mm_D2.5mm_P10.16mm_Horizontal
R20, R24: 2.2M; R_Axial_DIN0207_L6.3mm_D2.5mm_P10.16mm_Horizontal
R22: 220; R_Axial_DIN0207_L6.3mm_D2.5mm_P10.16mm_Horizontal
R25: 12k; R_Axial_DIN0207_L6.3mm_D2.5mm_P10.16mm_Horizontal
R27: 1k; R_Axial_DIN0207_L6.3mm_D2.5mm_P10.16mm_Horizontal
R28: R; R_Axial_DIN0207_L6.3mm_D2.5mm_P10.16mm_Horizontal
R32: 670k; R_Axial_DIN0207_L6.3mm_D2.5mm_P10.16mm_Horizontal
R35: 560k; R_Axial_DIN0207_L6.3mm_D2.5mm_P10.16mm_Horizontal
RV2: 10k; Potentiometer_Piher_PT-6-V_Vertical
SW1: SW_DIP_x02; SW_DIP_SPSTx02_Slide_6.7x6.64mm_W7.62mm_P2.54mm_LowProfile
U1, U2: TL072; SO-8_5.3x6.2mm_P1.27mm
U3: MCP46x2; MSOP-10_3x3mm_P0.5mm

Connections:
5V: J3.15, J3.16, R23.2, R26.2, U3.10 (VDD)
+12V: J3.9, J3.10, R7.2, R13.2, R36.1, U1.8 (V+), U2.8 (V+)
-12V: J3.11, J3.12, U1.4 (V-), U2.4 (V-)
A0: R23.1, SW1.2, U3.1 (A0)
A1: R26.1, SW1.1, U3.9 (A1)
A_IN: J3.5, J3.6
A_OUT_L: J3.1, J3.2
A_OUT_R: J3.3, J3.4
Audio_Out: C19.2, J2.2, U3.5 (P1B)
DET: J3.17, J3.18
DIGI1: J1.2, R18.2, R22.1, U3.8 (P0B)
GND: C1.2, C3.2, C8.2, C9.2, C17.2, J1.3, J2.3, J3.7, J3.8, J3.13, J3.14, Q1.2 (B), R5.2, R8.2, R9.2, R10.2, R16.2, R18.1, R27.2, R29.2, R31.2, R34.2, RV2.3, SW1.3, SW1.4, U1.5 (+), U3.4 (VSS), U3.6 (P1W), U3.7 (P0W)
unnamed: C1.1, R1.2, R2.2
unnamed: C2.1, Q1.1 (E), R2.1
unnamed: C2.2, R3.2
unnamed: C3.1, R1.1, R4.1, R7.1
unnamed: C4.1, R6.1, U1.1
unnamed: C5.1, D2.1 (K), R9.1
unnamed: C6.1, D1.1 (K), R8.1
unnamed: C7.1, R12.2
unnamed: C7.2, D1.2 (A), R10.1
unnamed: C8.1, R11.1, R14.2
unnamed: C9.1, R13.1, R15.1
unnamed: C10.1, C13.2, R22.2
unnamed: C10.2, R20.2, R21.2, U2.5 (+)
unnamed: C11.1, D3.1 (K), D4.2 (A), R24.2
unnamed: C11.2, R20.1
unnamed: C12.1, R25.2
unnamed: C12.2, RV2.2
unnamed: C13.1, C14.1, D3.2 (A), D4.1 (K), R21.1, R24.1, U2.7
unnamed: C14.2, R28.2, R29.1, R30.2
unnamed: C15.1, C16.1, C18.2, R35.1, U2.3 (+)
unnamed: C15.2, Q2.3 (E), R31.1
unnamed: C16.2, R32.1
unnamed: C17.1, R33.1, R36.2
unnamed: C18.1, C19.1, R35.2, U2.1
unnamed: D2.2 (A), R11.2
unnamed: Q2.1 (C), R25.1, R27.1
unnamed: Q2.2 (B), R19.2, R28.1
unnamed: R3.1, R6.2, U1.3 (+)
unnamed: R4.2, R5.1, U1.2 (-)
unnamed: R12.1, R15.2, R16.1, U2.6 (-)
unnamed: R14.1, R19.1
unnamed: R17.2, RV2.1
unnamed: R30.1, R32.2
unnamed: R33.2, R34.1, U2.2 (-)
unnamed: U1.6 (-), U1.7
SCL: J3.21, J3.22, U3.2 (SCL)
SDA: J3.19, J3.20, U3.3 (SDA)
TRIG: C5.2, C6.2, J3.23, J3.24
White_Noise: C4.2, R17.1

Notes on the sheet:
Noise Generator
Trim-Pot for noise level
Negative Input Trigger
Thru Holes
Thru Holes
Through holes would be good here. Set up so that resistance ranges from 220 to 2.2k based on pot values
Thru Holes
Digipot and Analog Pot

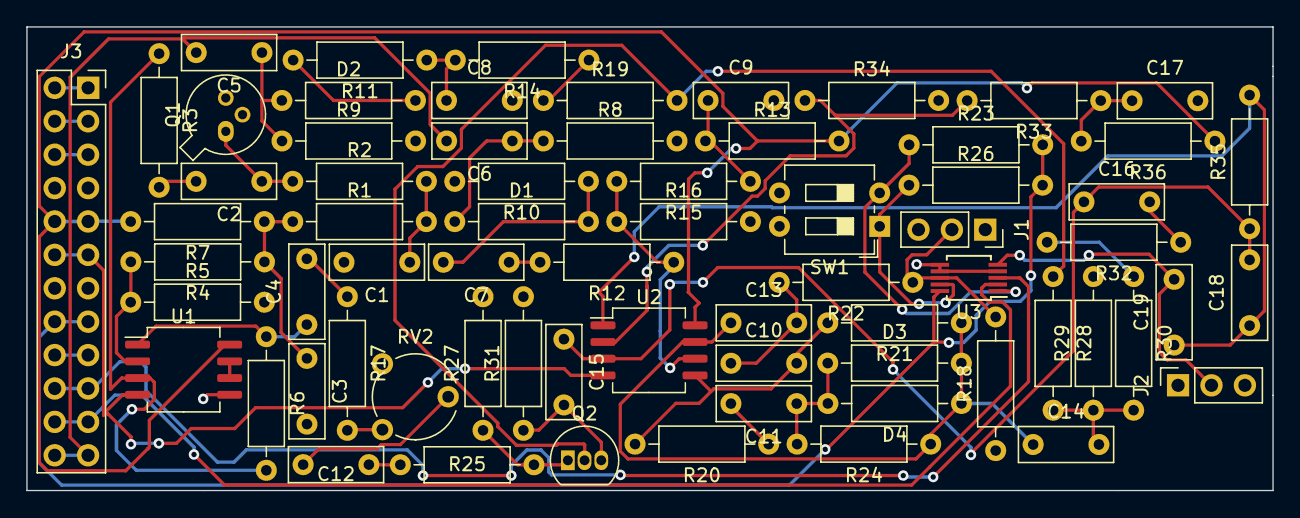
[picture p51: board Snare_For_Reid_Rev1.kicad_pcb from above]

Board: 2 copper layers, 94.8 x 35.2 mm, 69 parts (0 on the bottom side), 51 nets.
