VegaDeftwing/AnalogDrumMachine/PCBs/bassDrum/bassDrum.kicad_pcb

## KiCad design PCBs/bassDrum/bassDrum.kicad_pcb (2022-04-01)

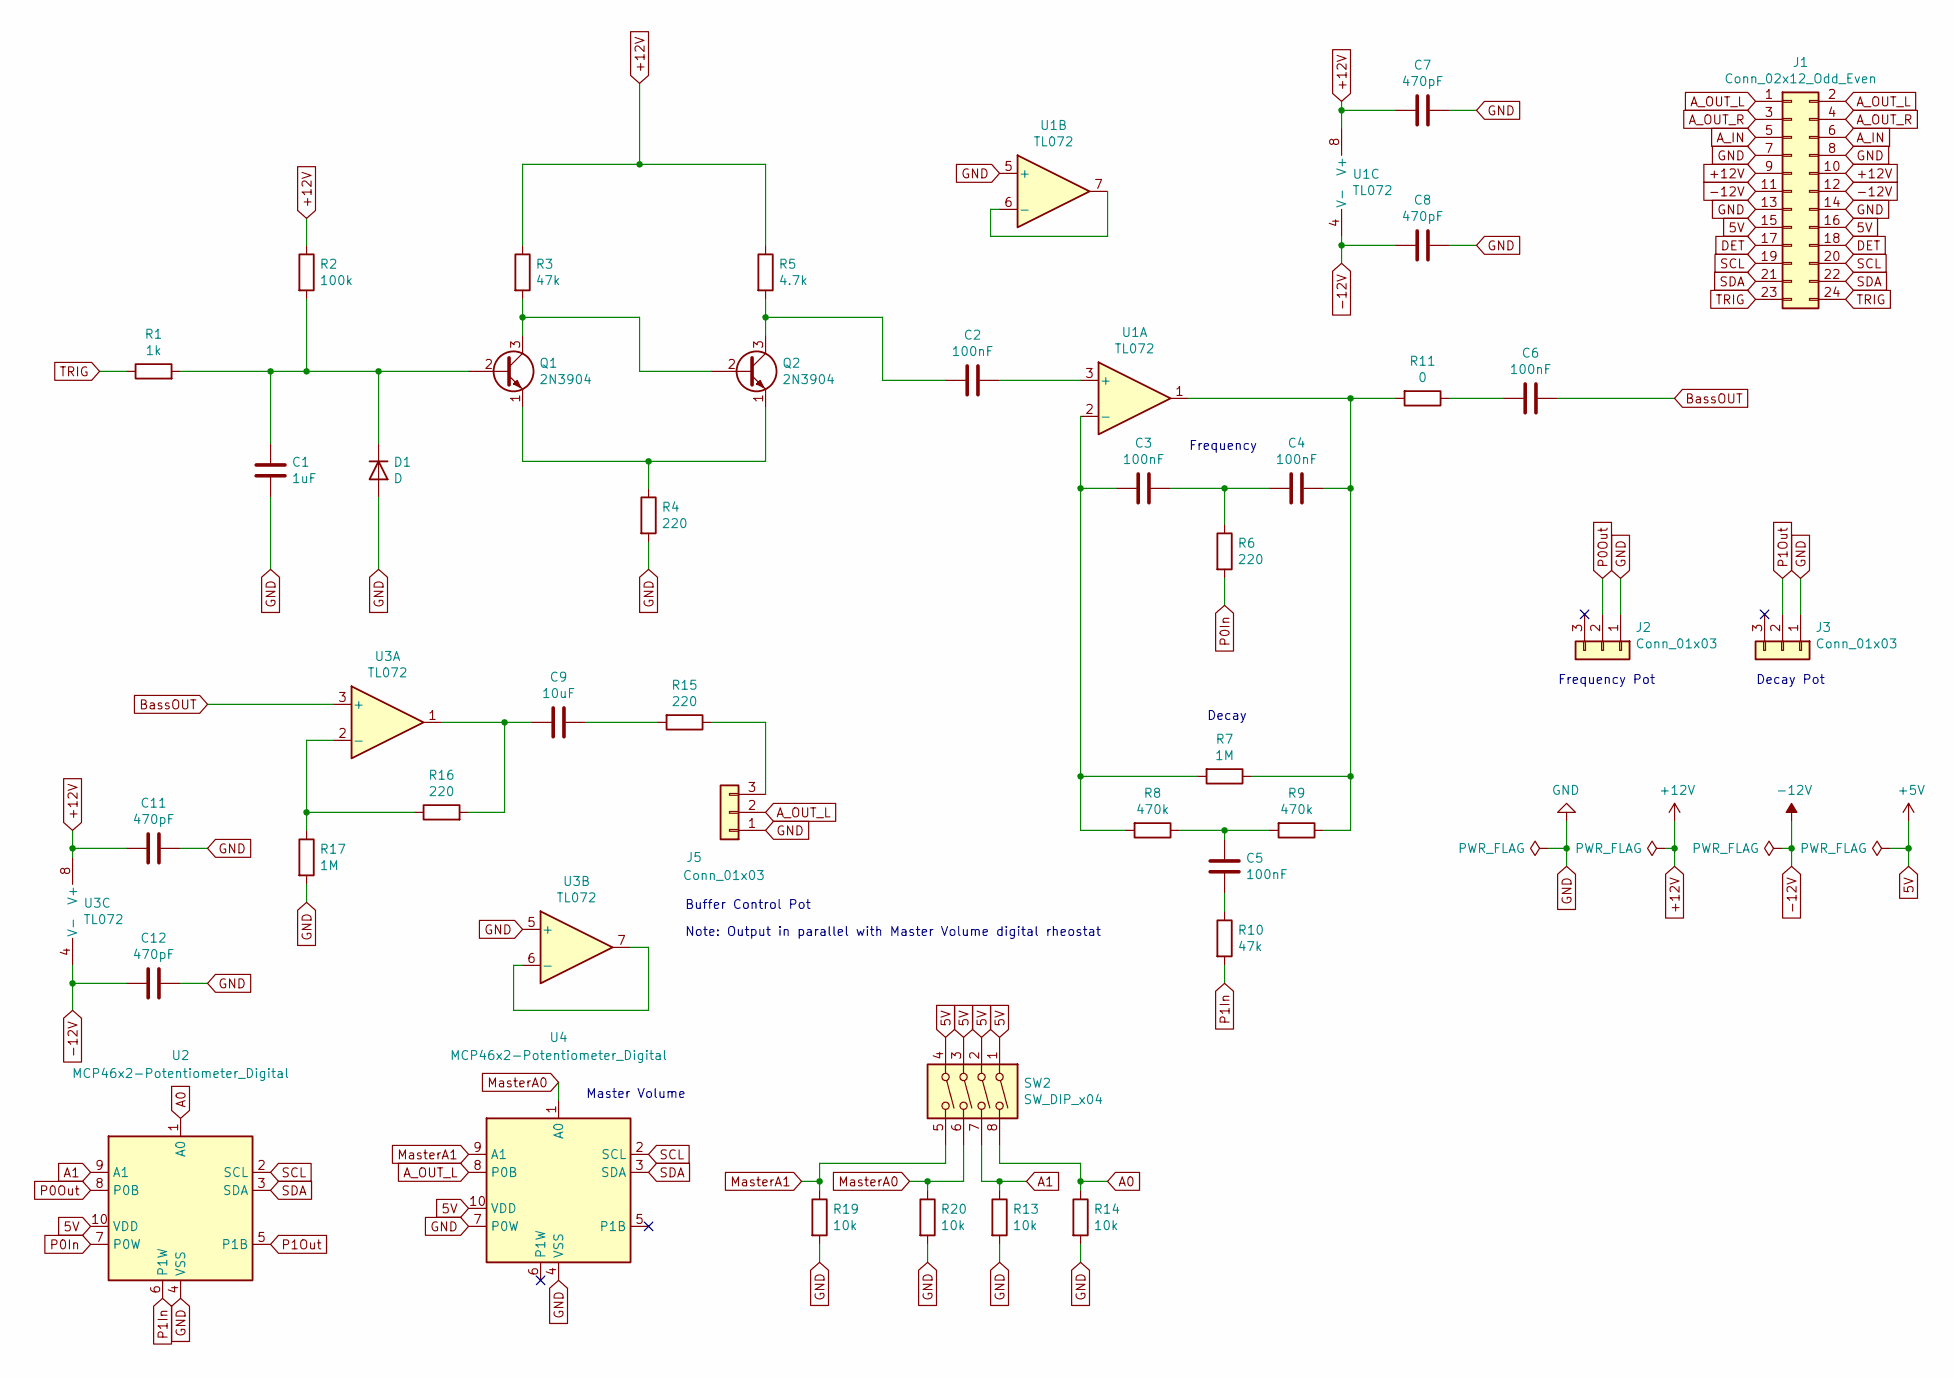
[picture p52: schematic bassDrum.sch]

Parts:
C1: 1uF; C_0805_2012Metric
C2, C3, C4, C5, C6: 100nF; C_0805_2012Metric
C7, C8, C11, C12: 470pF; C_0805_2012Metric
C9: 10uF; C_0805_2012Metric
D1: D; D_DO-41_SOD81_P7.62mm_Horizontal
J1: Conn_02x12_Odd_Even; PinHeader_2x12_P2.54mm_Vertical
J2, J3, J5: Conn_01x03; PinHeader_1x03_P2.54mm_Vertical
Q1, Q2: 2N3904; TO-92_Inline
R1: 1k; R_0805_2012Metric
R2: 100k; R_0805_2012Metric
R3, R10: 47k; R_0805_2012Metric
R4, R6, R15, R16: 220; R_0805_2012Metric
R5: 4.7k; R_0805_2012Metric
R7, R17: 1M; R_0805_2012Metric
R8, R9: 470k; R_0805_2012Metric
R11: 0; R_0805_2012Metric
R13, R14, R19, R20: 10k; R_0805_2012Metric
SW2: SW_DIP_x04; SW_DIP_SPSTx04_Slide_6.7x11.72mm_W7.62mm_P2.54mm_LowProfile
U1, U3: TL072; SO-8_5.3x6.2mm_P1.27mm
U2, U4: MCP46x2-Potentiometer_Digital; MSOP-10_3x3mm_P0.5mm

Connections:
5V: J1.15, J1.16, SW2.1, SW2.2, SW2.3, SW2.4, U2.10 (VDD), U4.10 (VDD)
+12V: C7.2, C11.2, J1.9, J1.10, R2.1, R3.1, R5.1, U1.8 (V+), U3.8 (V+)
-12V: C8.2, C12.2, J1.11, J1.12, U1.4 (V-), U3.4 (V-)
A0: R14.1, SW2.8, U2.1 (A0)
A1: R13.1, SW2.7, U2.9 (A1)
A_IN: J1.5, J1.6
A_OUT_L: J1.1, J1.2, J5.2, U4.8 (P0B)
A_OUT_R: J1.3, J1.4
BassOUT: C6.1, U3.3 (+)
DET: J1.17, J1.18
GND: C1.2, C7.1, C8.1, C11.1, C12.1, D1.2 (A), J1.7, J1.8, J1.13, J1.14, J2.1, J3.1, J5.1, R4.2, R13.2, R14.2, R17.2, R19.2, R20.2, U1.5 (+), U2.4 (VSS), U3.5 (+), U4.4 (VSS), U4.7 (P0W)
MasterA0: R20.1, SW2.6, U4.1 (A0)
MasterA1: R19.1, SW2.5, U4.9 (A1)
unnamed: C1.1, D1.1 (K), Q1.2 (B), R1.2, R2.2
unnamed: C2.1, Q2.3 (C), R5.2
unnamed: C2.2, U1.3 (+)
unnamed: C3.1, R7.2, R8.2, U1.2 (-)
unnamed: C3.2, C4.1, R6.1
unnamed: C4.2, R7.1, R9.1, R11.2, U1.1
unnamed: C5.1, R8.1, R9.2
unnamed: C5.2, R10.1
unnamed: C6.2, R11.1
unnamed: C9.1, R15.2
unnamed: C9.2, R16.2, U3.1
unnamed: J5.3, R15.1
unnamed: Q1.1 (E), Q2.1 (E), R4.1
unnamed: Q1.3 (C), Q2.2 (B), R3.2
unnamed: R16.1, R17.1, U3.2 (-)
unnamed: U1.6 (-), U1.7
unnamed: U3.6 (-), U3.7
P0In: R6.2, U2.7 (P0W)
P0Out: J2.2, U2.8 (P0B)
P1In: R10.2, U2.6 (P1W)
P1Out: J3.2, U2.5 (P1B)
SCL: J1.19, J1.20, U2.2 (SCL), U4.2 (SCL)
SDA: J1.21, J1.22, U2.3 (SDA), U4.3 (SDA)
TRIG: J1.23, J1.24, R1.1

Notes on the sheet:
Decay
Frequency
Buffer Control Pot
Decay Pot
Frequency Pot
Master Volume
Note: Output in parallel with Master Volume digital rheostat

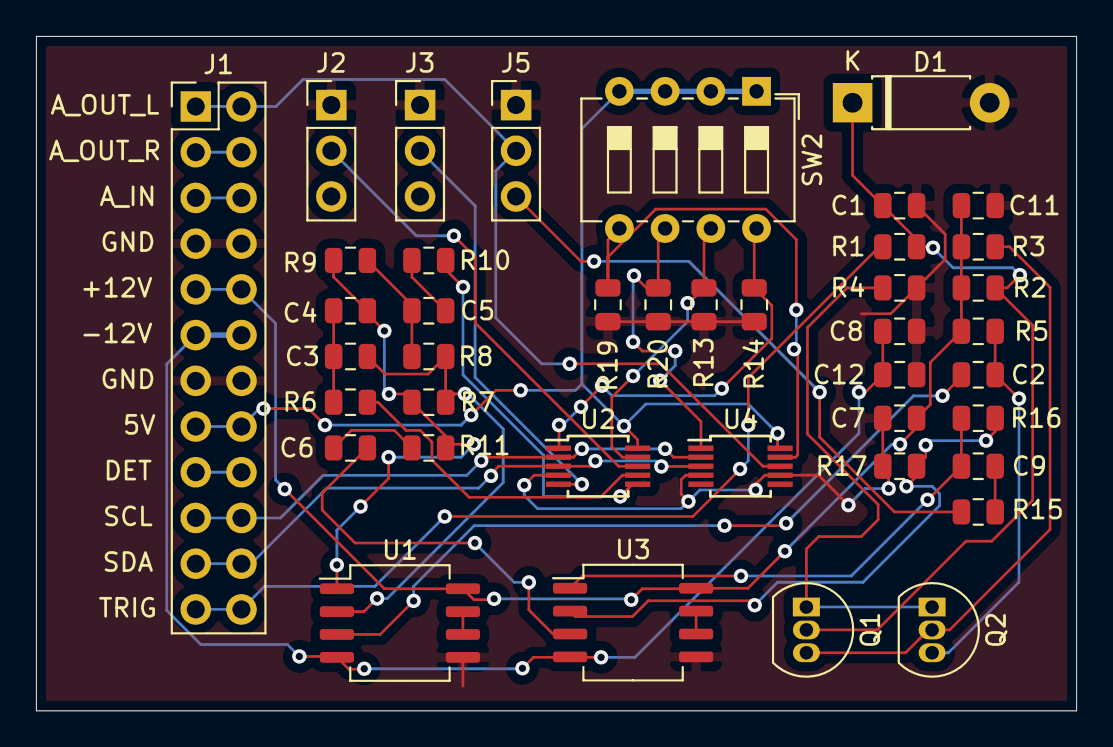
[picture p53: board bassDrum.kicad_pcb from above]

Board: 2 copper layers, 57.8 x 37.5 mm, 41 parts (0 on the bottom side), 37 nets.
