VegaDeftwing/AnalogDrumMachine/PCBs/rev1/rev1.kicad_pcb

## KiCad design PCBs/rev1/rev1.kicad_pcb (2022-03-25)

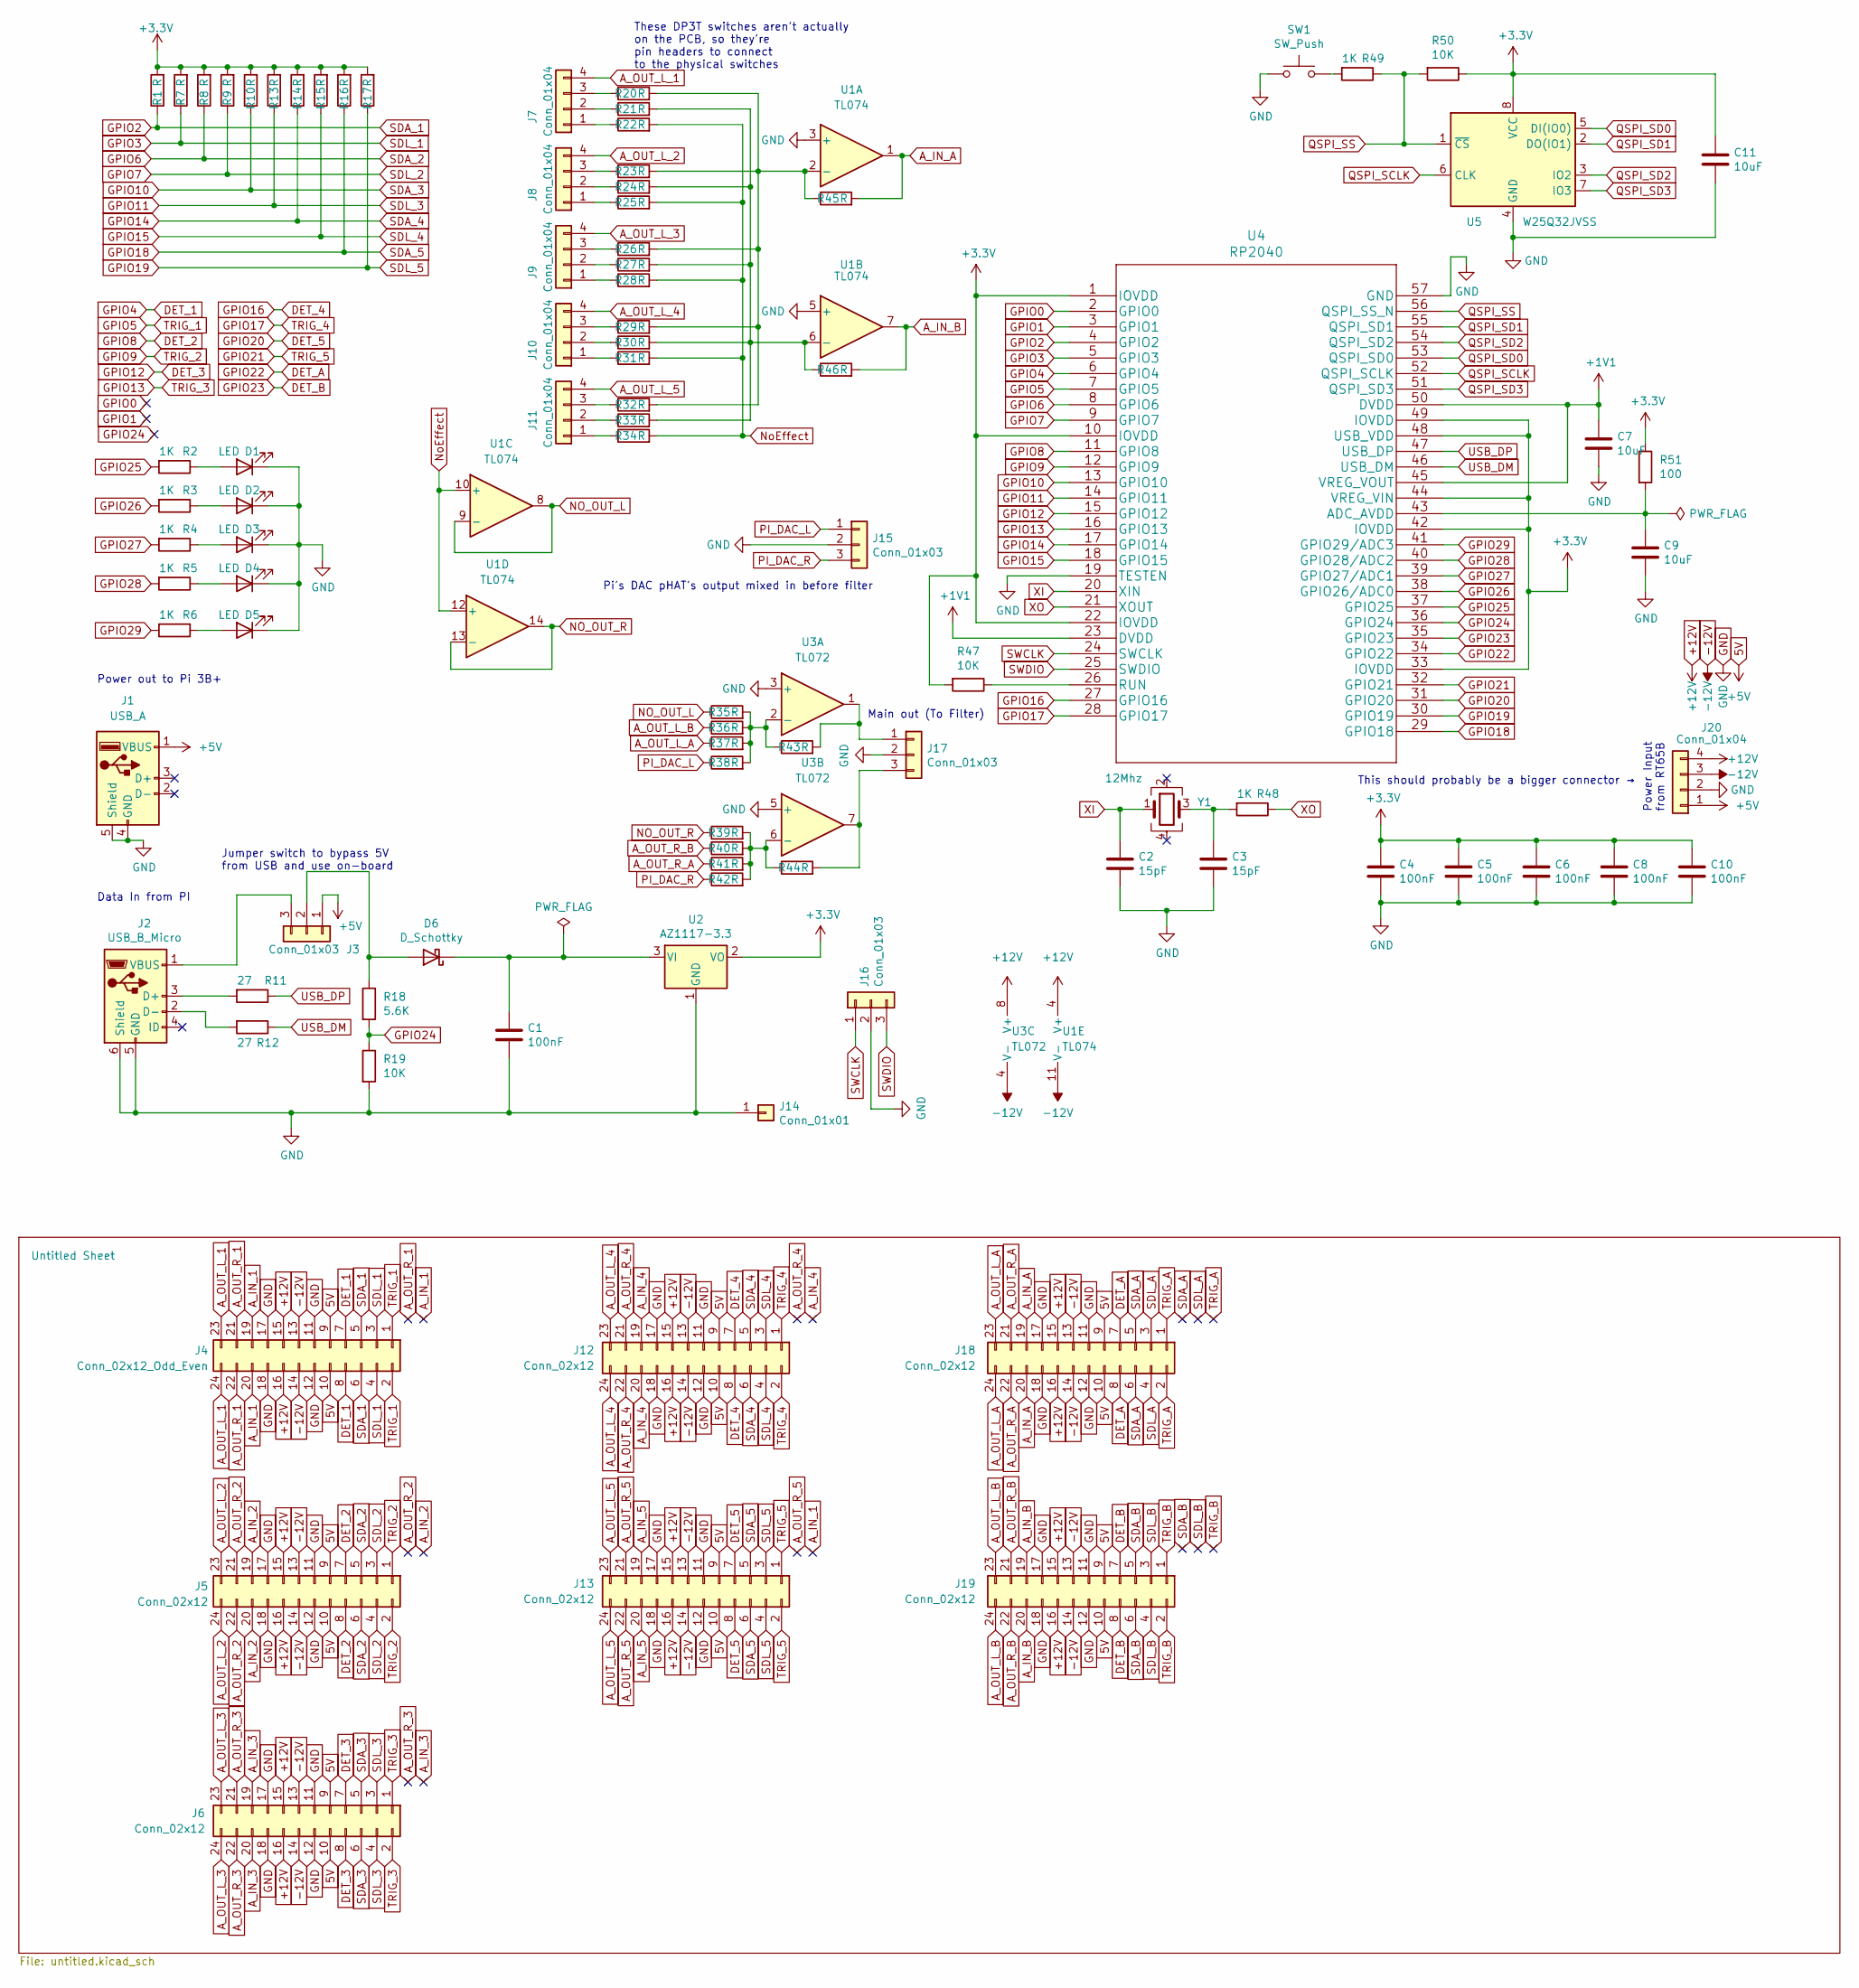
[picture p54: schematic rev1.kicad_sch, RP2040 REV01]

Parts:
C1, C4, C5, C6, C8, C10: 100nF; C_0805_2012Metric
C2, C3: 15pF; C_0805_2012Metric
C7, C9, C11: 10uF; C_0805_2012Metric
D1, D2, D3, D4, D5: LED; LED_0805_2012Metric
D6: D_Schottky; D_1206_3216Metric
J1: USB_A; PinHeader_1x04_P2.54mm_Vertical
J2: USB_B_Micro; USB_Micro-B_Molex_47346-0001
J3, J15, J16, J17: Conn_01x03; PinHeader_1x03_P2.54mm_Vertical
J4: Conn_02x12_Odd_Even; PinHeader_2x12_P2.54mm_Vertical
J5, J6, J12, J13, J18, J19: Conn_02x12; PinHeader_2x12_P2.54mm_Vertical
J7, J8, J9, J10, J11: Conn_01x04; PinHeader_1x04_P2.54mm_Vertical
J14: Conn_01x01; PinHeader_1x01_P2.54mm_Vertical
J20: Conn_01x04; PhoenixContact_GMSTBA_2,5_4-G_1x04_P7.50mm_Horizontal
R1, R7, R8, R9, R10, R13, R14, R15, R16, R17, R20, R21, R22, R23, R24, R25, R26, R27, R28, R29, R30, R31, R32, R33, R34, R35, R36, R37, R38, R39, R40, R41, R42, R43, R44, R45, R46: R; R_0805_2012Metric
R2, R3, R4, R5, R6, R48, R49: 1K; R_0805_2012Metric
R11, R12: 27; R_0805_2012Metric
R18: 5.6K; R_0805_2012Metric
R19, R47, R50: 10K; R_0805_2012Metric
R51: 100; R_0805_2012Metric
SW1: SW_Push; SW_SPST_CK_RS282G05A3
U1: TL074; SO-14_5.3x10.2mm_P1.27mm
U2: AZ1117-3.3; SOT-223-3_TabPin2
U3: TL072; SO-8_5.3x6.2mm_P1.27mm
U4: RP2040
U5: W25Q32JVSS; SOIC-8_5.23x5.23mm_P1.27mm
Y1: 12Mhz; Crystal_SMD_SeikoEpson_FA238-4Pin_3.2x2.5mm

Connections:
5V: J1.1 (VBUS), J3.1, J4.9, J4.10, J5.9, J5.10, J6.9, J6.10, J12.9, J12.10, J13.9, J13.10, J18.9, J18.10, J19.9, J19.10, J20.1
+1V1: C7.1, U4.23 (DVDD), U4.45 (VREG_VOUT), U4.50 (DVDD)
+3V3: C4.1, C5.1, C6.1, C8.1, C10.1, C11.1, R1.2, R7.2, R8.2, R9.2, R10.2, R13.2, R14.2, R15.2, R16.2, R17.2, R47.2, R50.1, R51.1, U2.2 (VO), U4.1 (IOVDD), U4.10 (IOVDD), U4.22 (IOVDD), U4.33 (IOVDD), U4.42 (IOVDD), U4.44 (VREG_VIN), U4.48 (USB_VDD), U4.49 (IOVDD), U5.8 (VCC)
+12V: J4.15, J4.16, J5.15, J5.16, J6.15, J6.16, J12.15, J12.16, J13.15, J13.16, J18.15, J18.16, J19.15, J19.16, J20.4, U1.4 (V+), U3.8 (V+)
-12V: J4.13, J4.14, J5.13, J5.14, J6.13, J6.14, J12.13, J12.14, J13.13, J13.14, J18.13, J18.14, J19.13, J19.14, J20.3, U1.11 (V-), U3.4 (V-)
A_IN_1: J4.19, J4.20
A_IN_2: J5.19, J5.20
A_IN_3: J6.19, J6.20
A_IN_4: J12.19, J12.20
A_IN_5: J13.19, J13.20
A_IN_A: J18.19, J18.20, R45.2, U1.1
A_IN_B: J19.19, J19.20, R46.2, U1.7
A_OUT_L_1: J4.23, J4.24, J7.4
A_OUT_L_2: J5.23, J5.24, J8.4
A_OUT_L_3: J6.23, J6.24, J9.4
A_OUT_L_4: J10.4, J12.23, J12.24
A_OUT_L_5: J11.4, J13.23, J13.24
A_OUT_L_A: J18.23, J18.24, R37.1
A_OUT_L_B: J19.23, J19.24, R36.1
A_OUT_R_1: J4.21, J4.22
A_OUT_R_2: J5.21, J5.22
A_OUT_R_3: J6.21, J6.22
A_OUT_R_4: J12.21, J12.22
A_OUT_R_5: J13.21, J13.22
A_OUT_R_A: J18.21, J18.22, R41.1
A_OUT_R_B: J19.21, J19.22, R40.1
DET_1: J4.7, J4.8, U4.6 (GPIO4)
DET_2: J5.7, J5.8, U4.11 (GPIO8)
DET_3: J6.7, J6.8, U4.15 (GPIO12)
DET_4: J12.7, J12.8, U4.27 (GPIO16)
DET_5: J13.7, J13.8, U4.31 (GPIO20)
DET_A: J18.7, J18.8, U4.34 (GPIO22)
DET_B: J19.7, J19.8, U4.35 (GPIO23)
GND: C1.2, C2.2, C3.2, C4.2, C5.2, C6.2, C7.2, C8.2, C9.2, C10.2, C11.2, D1.1 (K), D2.1 (K), D3.1 (K), D4.1 (K), D5.1 (K), J1.4 (GND), J1.5 (Shield), J2.5 (GND), J2.6 (Shield), J4.11, J4.12, J4.17, J4.18, J5.11, J5.12, J5.17, J5.18, J6.11, J6.12, J6.17, J6.18, J12.11, J12.12, J12.17, J12.18, J13.11, J13.12, J13.17, J13.18, J14.1, J15.2, J16.2, J17.2, J18.11, J18.12, J18.17, J18.18, J19.11, J19.12, J19.17, J19.18, J20.2, R19.2, SW1.1, U1.3 (+), U1.5 (+), U2.1 (GND), U3.3 (+), U3.5 (+), U4.19 (TESTEN), U4.57 (GND), U5.4 (GND)
GPIO0: U4.2 (GPIO0)
GPIO1: U4.3 (GPIO1)
GPIO2: J4.5, J4.6, R1.1, U4.4 (GPIO2)
GPIO3: J4.3, J4.4, R7.1, U4.5 (GPIO3)
GPIO5: J4.1, J4.2, U4.7 (GPIO5)
GPIO6: J5.5, J5.6, R8.1, U4.8 (GPIO6)
GPIO7: J5.3, J5.4, R9.1, U4.9 (GPIO7)
GPIO9: J5.1, J5.2, U4.12 (GPIO9)
GPIO10: J6.5, J6.6, R10.1, U4.13 (GPIO10)
GPIO11: J6.3, J6.4, R13.1, U4.14 (GPIO11)
GPIO13: J6.1, J6.2, U4.16 (GPIO13)
GPIO14: J12.5, J12.6, R14.1, U4.17 (GPIO14)
GPIO15: J12.3, J12.4, R15.1, U4.18 (GPIO15)
GPIO17: J12.1, J12.2, U4.28 (GPIO17)
GPIO18: J13.5, J13.6, R16.1, U4.29 (GPIO18)
GPIO19: J13.3, J13.4, R17.1, U4.30 (GPIO19)
GPIO21: J13.1, J13.2, U4.32 (GPIO21)
GPIO24: R18.2, R19.1, U4.36 (GPIO24)
GPIO25: R2.2, U4.37 (GPIO25)
GPIO26: R3.2, U4.38 (GPIO26/ADC0)
GPIO27: R4.2, U4.39 (GPIO27/ADC1)
GPIO28: R5.2, U4.40 (GPIO28/ADC2)
GPIO29: R6.2, U4.41 (GPIO29/ADC3)
NO_OUT_L: R35.1, U1.8, U1.9 (-)
NO_OUT_R: R39.1, U1.13 (-), U1.14
unnamed: C1.1, D6.1 (K), U2.3 (VI)
unnamed: C3.1, R48.2, Y1.3
unnamed: C9.1, R51.2, U4.43 (ADC_AVDD)
unnamed: D1.2 (A), R2.1
unnamed: D2.2 (A), R3.1
unnamed: D3.2 (A), R4.1
unnamed: D4.2 (A), R5.1
unnamed: D5.2 (A), R6.1
unnamed: D6.2 (A), J3.2, R18.1
unnamed: J2.1 (VBUS), J3.3
unnamed: J2.2 (D-), R12.2
unnamed: J2.3 (D+), R11.2
unnamed: J7.1, R22.1
unnamed: J7.2, R21.1
unnamed: J7.3, R20.1
unnamed: J8.1, R25.1
unnamed: J8.2, R24.1
unnamed: J8.3, R23.1
unnamed: J9.1, R28.1
unnamed: J9.2, R27.1
unnamed: J9.3, R26.1
unnamed: J10.1, R31.1
unnamed: J10.2, R30.1
unnamed: J10.3, R29.1
unnamed: J11.1, R34.1
unnamed: J11.2, R33.1
unnamed: J11.3, R32.1
unnamed: J17.1, R43.2, U3.1
unnamed: J17.3, R44.2, U3.7
unnamed: R20.2, R23.2, R26.2, R29.2, R32.2, R45.1, U1.2 (-)
unnamed: R21.2, R24.2, R27.2, R30.2, R33.2, R46.1, U1.6 (-)
unnamed: R35.2, R36.2, R37.2, R38.2, R43.1, U3.2 (-)
unnamed: R39.2, R40.2, R41.2, R42.2, R44.1, U3.6 (-)
unnamed: R47.1, U4.26 (RUN)
unnamed: R49.2, SW1.2
NoEffect: R22.2, R25.2, R28.2, R31.2, R34.2, U1.10 (+), U1.12 (+)
PI_DAC_L: J15.1, R38.1
PI_DAC_R: J15.3, R42.1
QSPI_SCLK: U4.52 (QSPI_SCLK), U5.6 (CLK)
QSPI_SD0: U4.53 (QSPI_SD0), U5.5 (DI(IO0))
QSPI_SD1: U4.55 (QSPI_SD1), U5.2 (DO(IO1))
QSPI_SD2: U4.54 (QSPI_SD2), U5.3 (IO2)
QSPI_SD3: U4.51 (QSPI_SD3), U5.7 (IO3)
QSPI_SS: R49.1, R50.2, U4.56 (QSPI_SS_N), U5.1 (~CS)
SDA_A: J18.5, J18.6
SDA_B: J19.5, J19.6
SDL_A: J18.3, J18.4
SDL_B: J19.3, J19.4
SWCLK: J16.1, U4.24 (SWCLK)
SWDIO: J16.3, U4.25 (SWDIO)
TRIG_A: J18.1, J18.2
TRIG_B: J19.1, J19.2
USB_DM: R12.1, U4.46 (USB_DM)
USB_DP: R11.1, U4.47 (USB_DP)
XI: C2.1, U4.20 (XIN), Y1.1
XO: R48.1, U4.21 (XOUT)

Notes on the sheet:
These DP3T switches aren't actually on the PCB, so they're pin headers to connect to the physical switches
Data In from PI
This should probably be a bigger connector →
Power Input from RT65B
Pi's DAC pHAT's output mixed in before filter
Main out (To Filter)
Power out to Pi 3B+
Jumper switch to bypass 5V from USB and use on-board

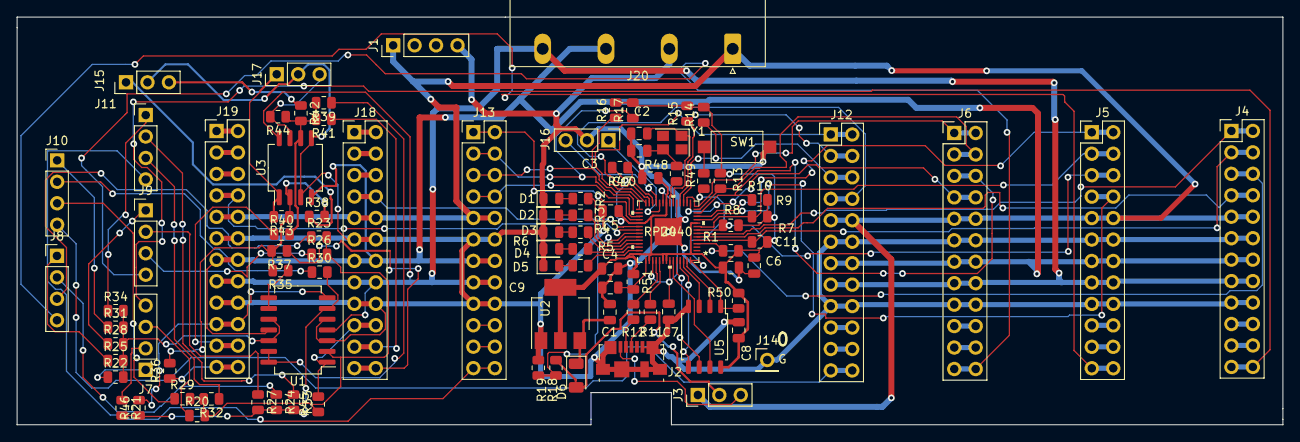
[picture p55: board rev1.kicad_pcb from above]

Board: 2 copper layers, 149.9 x 48.3 mm, 95 parts (0 on the bottom side), 113 nets.
