VegaDeftwing/AnalogDrumMachine/PCBs/GreenRinger/GreenRinger.kicad_pcb

## KiCad design PCBs/GreenRinger/GreenRinger.kicad_pcb (2022-03-15)

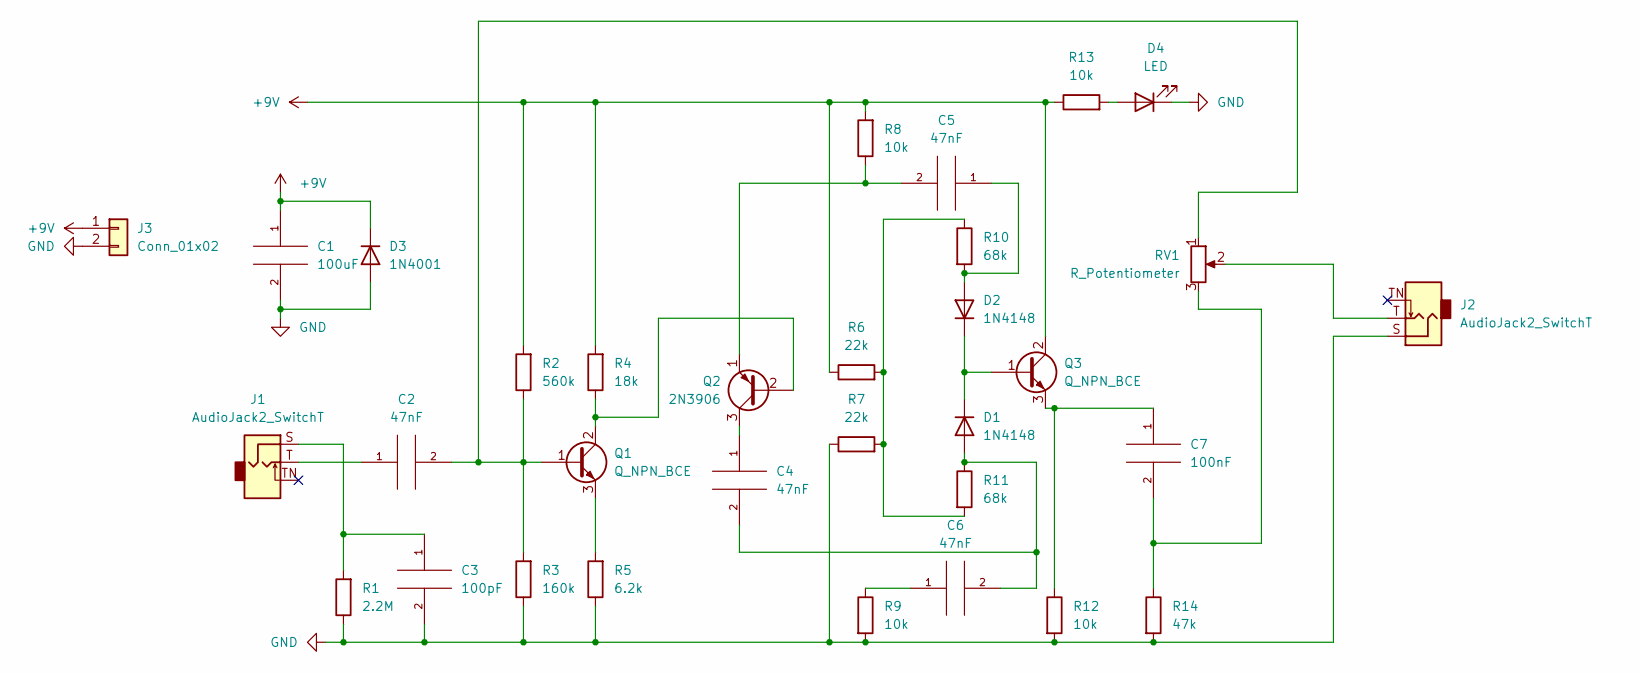
[picture p56: schematic GreenRinger.kicad_sch]

Parts:
C1: 100uF; CP_Radial_D4.0mm_P1.50mm
C2, C4, C5, C6: 47nF; C_Disc_D3.8mm_W2.6mm_P2.50mm
C3: 100pF; C_Disc_D3.8mm_W2.6mm_P2.50mm
C7: 100nF; C_Disc_D3.8mm_W2.6mm_P2.50mm
D1, D2: 1N4148; D_DO-35_SOD27_P7.62mm_Horizontal
D3: 1N4001; D_DO-41_SOD81_P10.16mm_Horizontal
D4: LED; LED_D1.8mm_W3.3mm_H2.4mm
J1, J2: AudioJack2_SwitchT; Jack_3.5mm_QingPu_WQP-PJ398SM_Vertical_CircularHoles
J3: Conn_01x02; PinHeader_1x02_P1.00mm_Vertical
Q1, Q3: Q_NPN_BCE; TO-92_Inline
Q2: 2N3906; TO-92_Inline
R1: 2.2M; R_Axial_DIN0204_L3.6mm_D1.6mm_P5.08mm_Horizontal
R2: 560k; R_Axial_DIN0204_L3.6mm_D1.6mm_P5.08mm_Horizontal
R3: 160k; R_Axial_DIN0204_L3.6mm_D1.6mm_P5.08mm_Horizontal
R4: 18k; R_Axial_DIN0204_L3.6mm_D1.6mm_P5.08mm_Horizontal
R5: 6.2k; R_Axial_DIN0204_L3.6mm_D1.6mm_P5.08mm_Horizontal
R6, R7: 22k; R_Axial_DIN0204_L3.6mm_D1.6mm_P5.08mm_Horizontal
R8, R9, R12, R13: 10k; R_Axial_DIN0204_L3.6mm_D1.6mm_P5.08mm_Horizontal
R10, R11: 68k; R_Axial_DIN0204_L3.6mm_D1.6mm_P5.08mm_Horizontal
R14: 47k; R_Axial_DIN0204_L3.6mm_D1.6mm_P5.08mm_Horizontal
RV1: R_Potentiometer; Potentiometer_ACP_CA9-V10_Vertical

Connections:
+9V: C1.1, D3.1 (K), J3.1, Q3.2 (C), R2.2, R4.2, R6.1, R8.2, R13.1
GND: C1.2, C3.2, D3.2 (A), D4.1 (K), J2.S, J3.2, R1.1, R3.1, R5.1, R7.1, R9.2, R12.2, R14.2
unnamed: C2.1, J1.T
unnamed: C3.1, J1.S, R1.2
unnamed: C6.1, R9.1
unnamed: C7.2, R14.1, RV1.3
unnamed: C4.2, C6.2, D1.2 (A), R11.1
unnamed: C5.1, D2.2 (A), R10.2
unnamed: D4.2 (A), R13.2
unnamed: J2.T, RV1.2
unnamed: C2.2, Q1.1 (B), R2.1, R3.2, RV1.1
unnamed: Q1.2 (C), Q2.2 (B), R4.1
unnamed: Q1.3 (E), R5.2
unnamed: C5.2, Q2.1 (E), R8.1
unnamed: C4.1, Q2.3 (C)
unnamed: D1.1 (K), D2.1 (K), Q3.1 (B)
unnamed: C7.1, Q3.3 (E), R12.1
unnamed: R6.2, R7.2, R10.1, R11.2

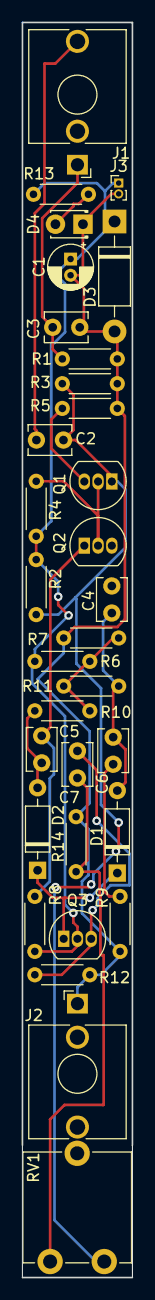
[picture p57: board GreenRinger.kicad_pcb from above]

Board: 2 copper layers, 10.2 x 116.0 mm, 32 parts (0 on the bottom side), 18 nets.
