VegaDeftwing/AnalogDrumMachine/Code/keyboards/capstone/config.h

#ifndef CONFIG_H
#define CONFIG_H

#include "config_common.h"

/* USB Device descriptor parameter */
#define VENDOR_ID       0xFEED
#define PRODUCT_ID      0x6060
#define DEVICE_VER      0x0001
#define MANUFACTURER    qmkbuilder
#define PRODUCT         keyboard
#define DESCRIPTION     Keyboard

/* key matrix size */
#define MATRIX_ROWS 3
#define MATRIX_COLS 10

/* key matrix pins */
#define MATRIX_ROW_PINS { D4, C6, D7 }
#define MATRIX_COL_PINS { E6, B4, B5, B6, B2, B3, B1, F7, F6, F5 }
#define UNUSED_PINS

/* COL2ROW or ROW2COL */
#define DIODE_DIRECTION COL2ROW

#define LED_DRIVER_ADDR_1 0b1110100
#define LED_DRIVER_COUNT 1
#define DRIVER_LED_TOTAL 30

/* number of backlight levels */

#ifdef BACKLIGHT_PIN
#define BACKLIGHT_LEVELS 3
#endif

/* Set 0 if debouncing isn't needed */
#define DEBOUNCING_DELAY 5

/* Mechanical locking support. Use KC_LCAP, KC_LNUM or KC_LSCR instead in keymap */
#define LOCKING_SUPPORT_ENABLE

/* Locking resynchronize hack */
#define LOCKING_RESYNC_ENABLE

/* key combination for command */
#define IS_COMMAND() ( \
    keyboard_report->mods == (MOD_BIT(KC_LSHIFT) | MOD_BIT(KC_RSHIFT)) \
)

/* prevent stuck modifiers */
#define PREVENT_STUCK_MODIFIERS


#ifdef RGB_DI_PIN
#define RGBLIGHT_ANIMATIONS
#define RGBLED_NUM 0
#define RGBLIGHT_HUE_STEP 8
#define RGBLIGHT_SAT_STEP 8
#define RGBLIGHT_VAL_STEP 8
#endif

#endif
