VegaDeftwing/AnalogDrumMachine/(commit log)

2021-09-17 I'm to tired to write a good commit message
2021-11-08 Create PCBs
2021-11-08 Add files via upload
    FM DRUM STUFF
    [dddd.kicad_pcb, dddd.sch]
2022-02-14 Digipot library and example code
    Include the folder containing header and source code in Arduino ide. Sketch->Include Library->Add .zip library
2022-02-19 main controller PCB + many journals, images, etc.
    [rev1.kicad_pcb, rev1.kicad_sch, rev1.sch, untitled.kicad_sch]
2022-03-03 fix data object not being independent per microstep
    [main.py]
2022-03-04 PCB
    dhwiqodhiowq
    [rev1.kicad_pcb, rev1.kicad_sch, rev1.sch]
2022-03-11 RP2040 BOM
    [RP2040ControlBoardBOM.xlsx]
2022-03-11 BOM change
    [RP2040ControlBoardBOM.xlsx]
2022-03-11 Alphabetized BOM
    [RP2040ControlBoardBOM.xlsx]
2022-03-11 update purrdata patch, add sample display code
2022-03-11 added green ringer PCB
    [GreenRinger.kicad_pcb, GreenRinger.kicad_sch]
2022-03-15 Control Board BOM
    -noted what we currently have in stock
    [ControlBoardBOM.xlsx, RP2040ControlBoardBOM.xlsx]
2022-03-25 PROJECT SPEC 6
    Added Project Spec 6
    [rev1-B_Cu.gbl, rev1-B_Mask.gbs, rev1-B_Paste.gbp, rev1-B_Silkscreen.gbo, rev1-Edge_Cuts.gm1, rev1-F_Cu.gtl, rev1-F_Mask.gts, rev1-F_Paste.gtp]
2022-03-26 many bug fixes, pattern sequencing, copy/paste, save/restore
    [main.py]
2022-04-01 bass drum v2, delay, and green ringer
    [bassDrum-B_Cu.gbl, bassDrum-B_Mask.gbs, bassDrum-B_Paste.gbp, bassDrum-B_SilkS.gbo, bassDrum-Edge_Cuts.gm1, bassDrum-F_Cu.gtl, bassDrum-F_Mask.gts, bassDrum-F_Paste.gtp]
2022-04-05 add openscad file
    [drumbox.scad]
2022-04-08 Updated OpenSCAD
    [drumbox.scad, drumbox_flat.scad]
2022-04-18 delay effect
    [delayEffect.kicad_pcb, delayEffect.sch]
2022-04-19 control board hihat and bass
    -code.py successfully sending I2C over multiple ports, sending triggers, and flashing LEDs
2022-04-22 add current keyboard code, needs to be in QMK keyboards to use
2022-04-29 fix drum selection display
    [main.py]
2022-05-01 Control Board Code 05/01/2022
    -test from friday
    -working hihat and snare
2022-05-01 fix minor logic issue affecting UI
    [main.py]
2022-05-02 05/01/2022
    -successful hihat, snare and digital drum test
    -fixed GP3 bug
    [code.py]
2022-05-05 k
    n
    [Hihat.kicad_pcb, Hihat.sch, dddd.kicad_pcb, dddd.sch, drumbox.scad, drumbox_flat.dxf, drumbox_flat.scad, drumbox_flat_back.dxf]
2022-05-05 Power Stuff
2022-05-11 control board code final commit
